olive-robotics/bots_bento_icra24/docs/images/6.JPG

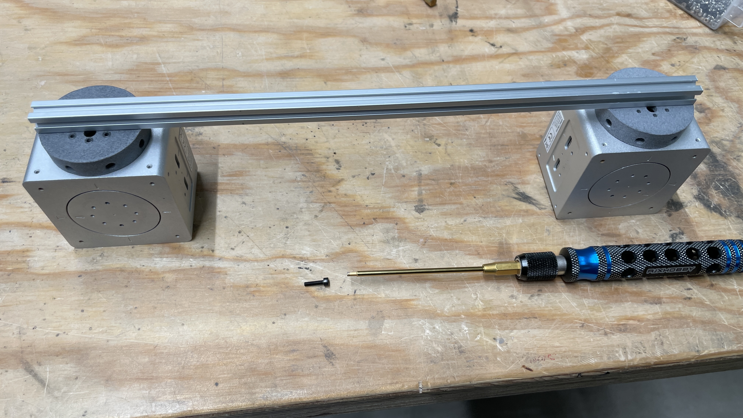
docs/images/6.JPG
