olive-robotics/bots_bento_icra24/docs/images/12.JPG

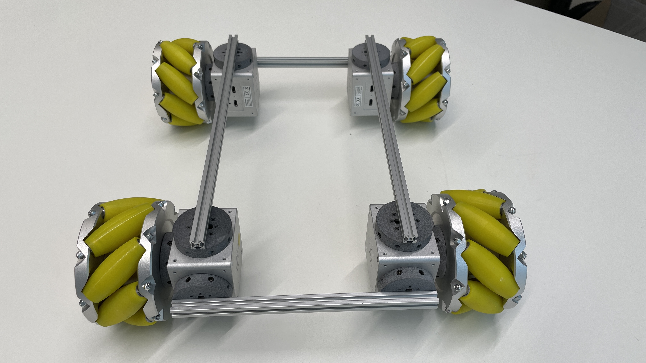
docs/images/12.JPG
