olive-robotics/bots_bento_icra24/docs/images/ant_wire2.png

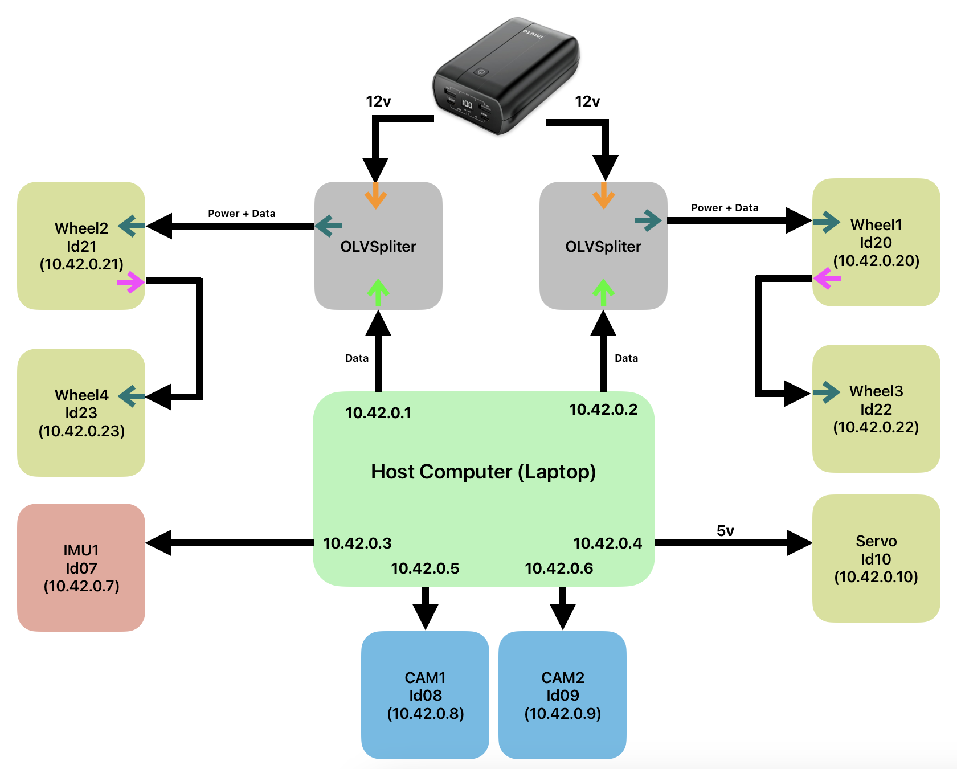
docs/images/ant_wire2.png
