olive-robotics/bots_bento_icra24/docs/images/ant_wire3.png

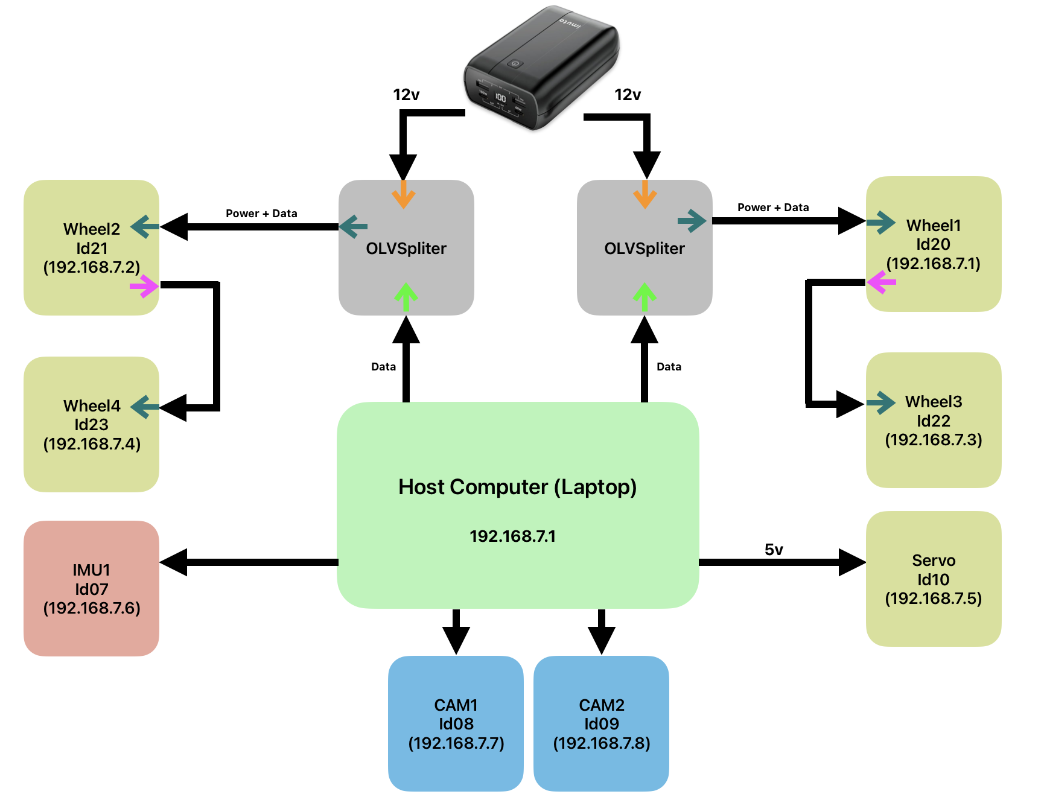
docs/images/ant_wire3.png
