olive-robotics/bots_bento_icra24/docs/images/splitter.JPG

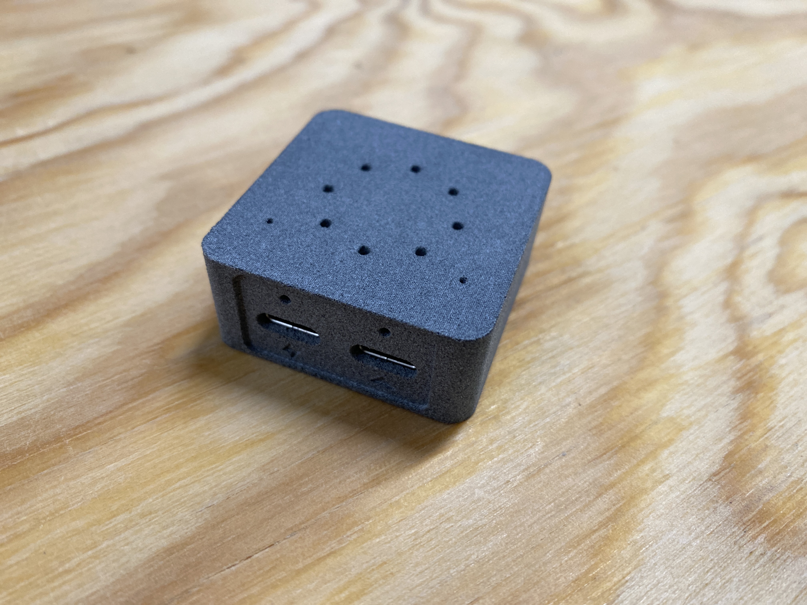
docs/images/splitter.JPG
