olive-robotics/bots_bento_icra24/images/1.png

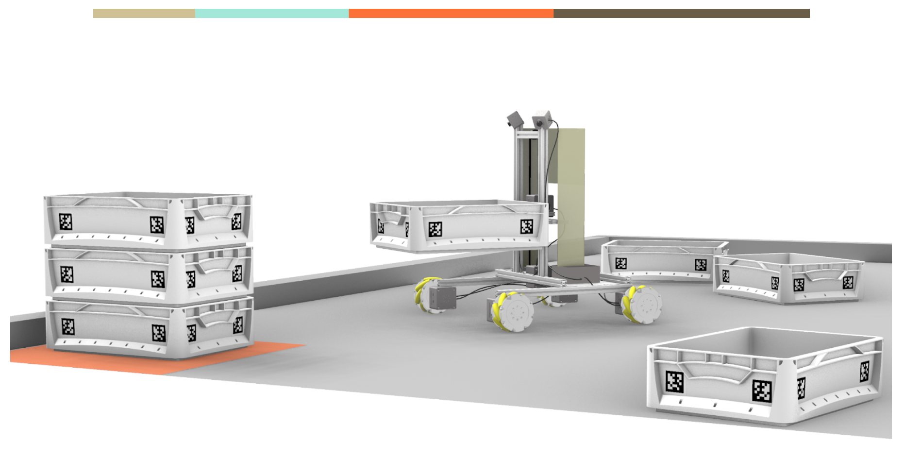
images/1.png
