olive-robotics/bots_bento_icra24/images/2xWheel_PlasticBox_400х300_v0.png

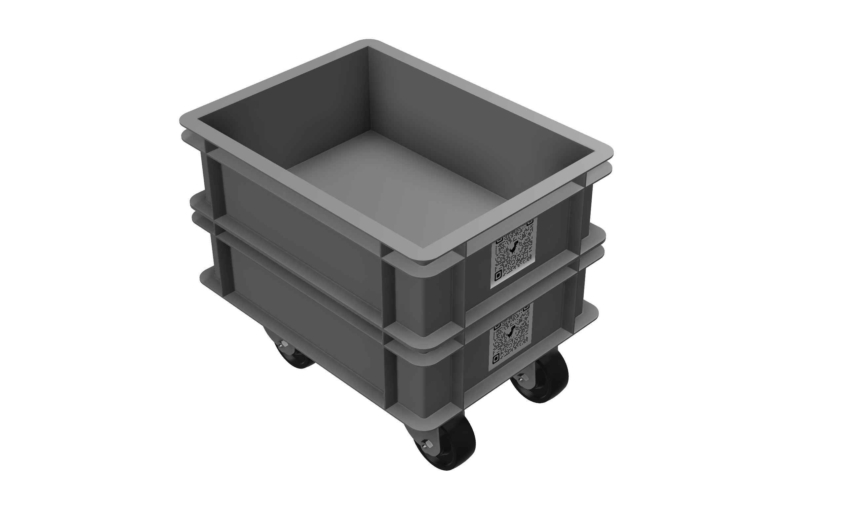
images/2xWheel_PlasticBox_400х300_v0.png
