olive-robotics/bots_bento_icra24/images/3.png

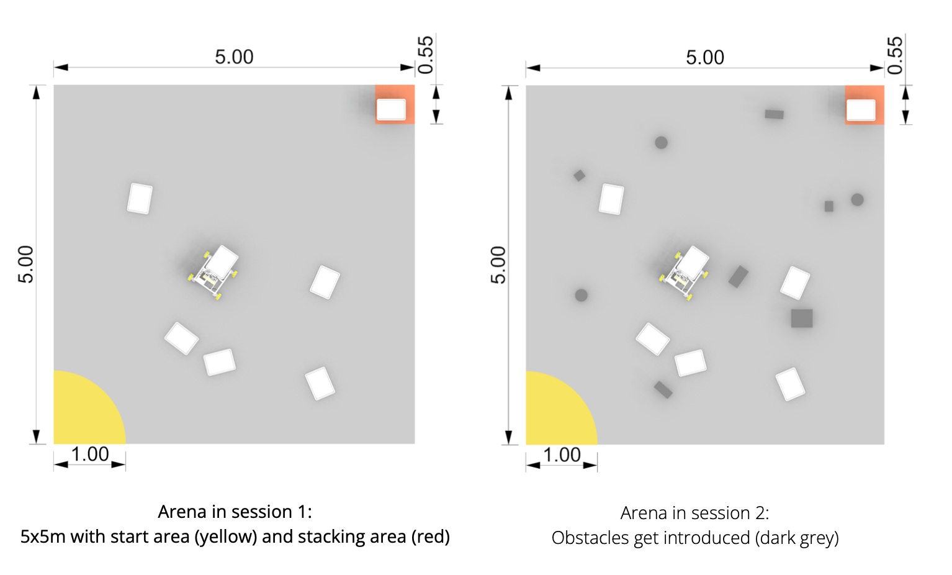
images/3.png
