olive-robotics/bots_bento_icra24/images/3xWheel_PlasticBox_400х300_v0.png

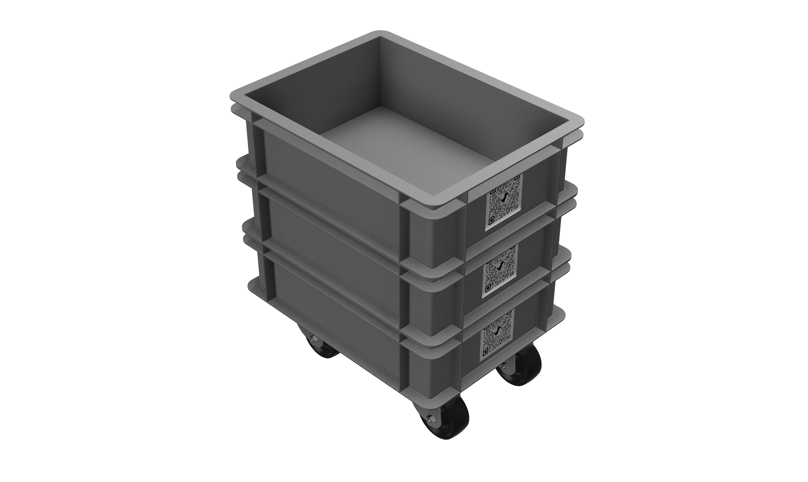
images/3xWheel_PlasticBox_400х300_v0.png
