olive-robotics/bots_bento_icra24/images/13.png

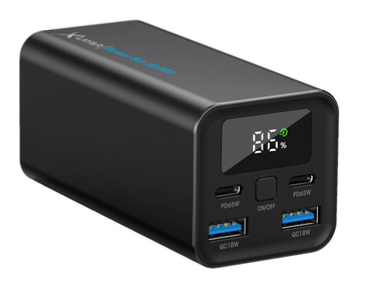
images/13.png
