olive-robotics/bots_bento_icra24/images/15.png

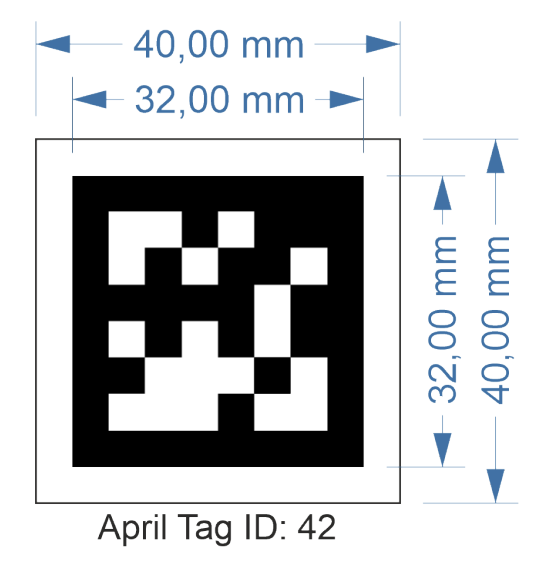
images/15.png
