olive-robotics/bots_bento_icra24/images/17.png

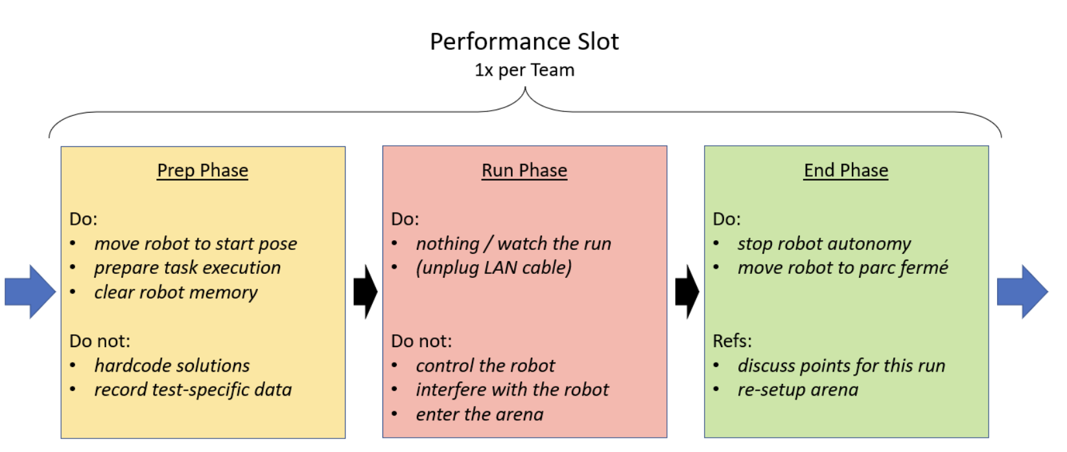
images/17.png
