olive-robotics/bots_bento_icra24/images/a1-3.png

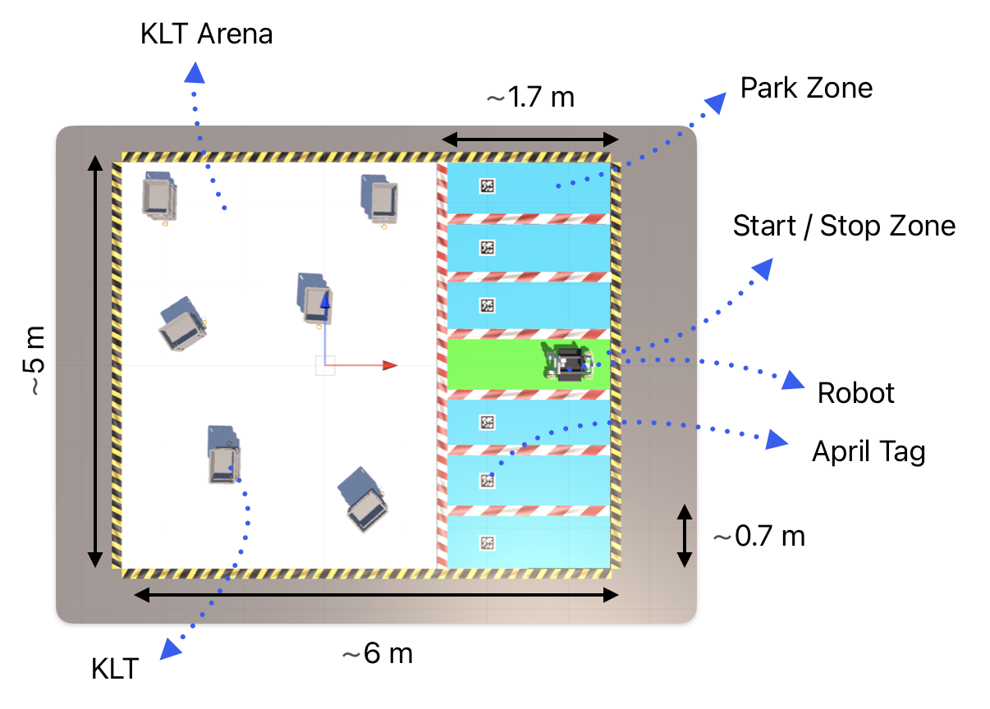
images/a1-3.png
