olive-robotics/bots_bento_icra24/images/a1.png

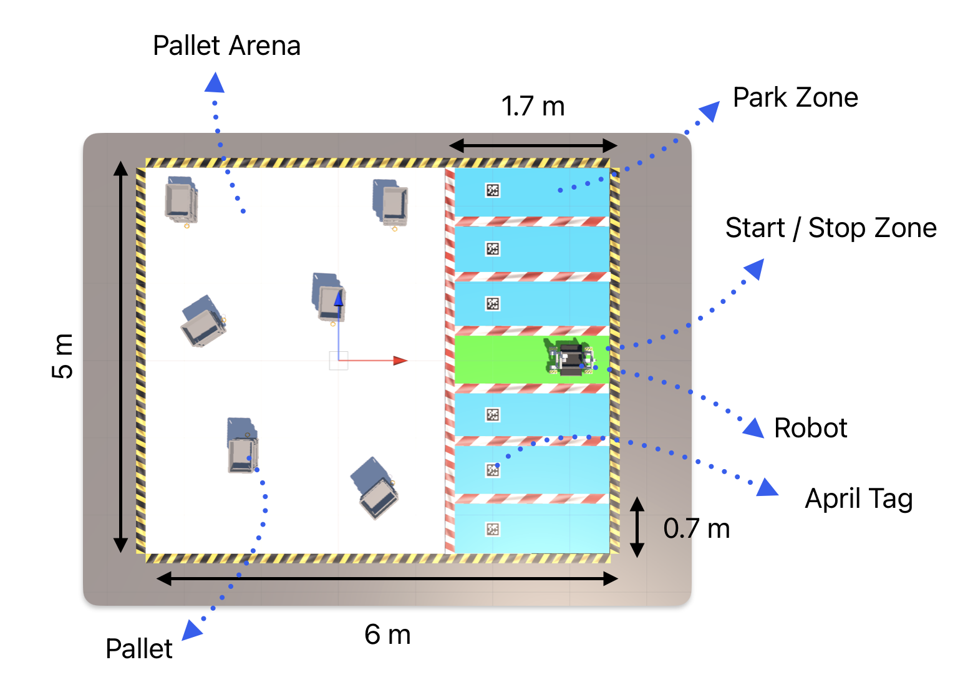
images/a1.png
