olive-robotics/bots_bento_icra24/images/a4-2.png

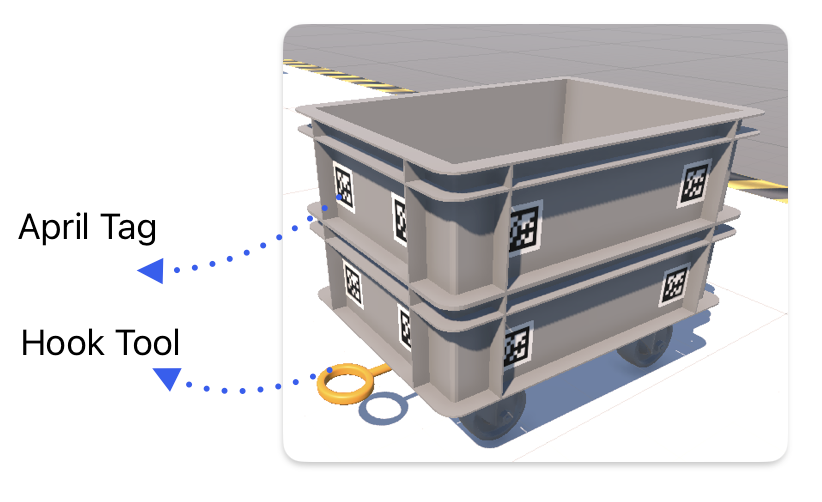
images/a4-2.png
