olive-robotics/bots_bento_icra24/images/a4.png

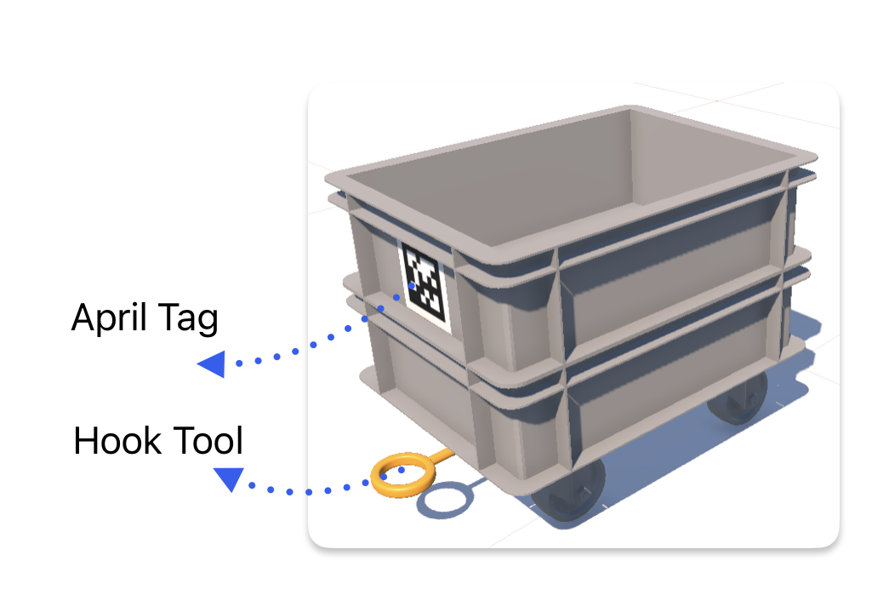
images/a4.png
