olive-robotics/bots_bento_icra24/images/ant.png

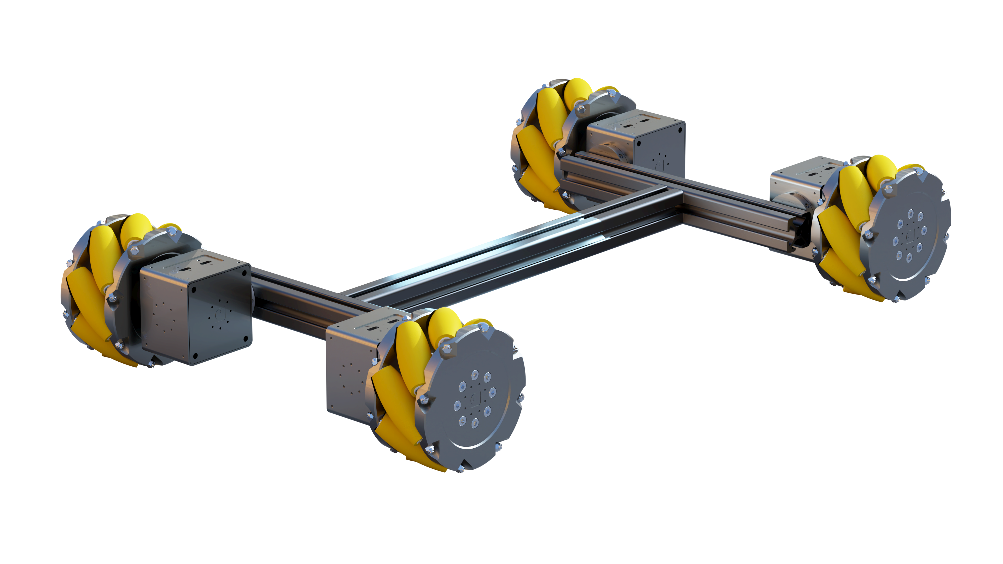
images/ant.png
