olive-robotics/bots_bento_icra24/images/bento.webp

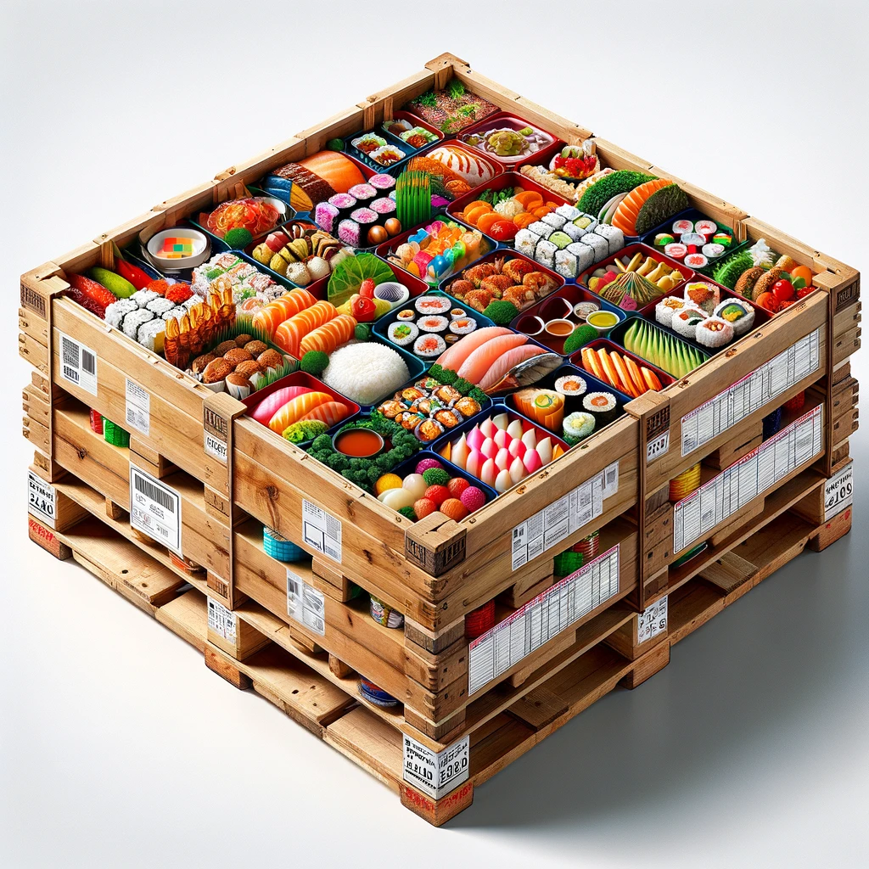
images/bento.webp
