olive-robotics/bots_bento_icra24/images/Competition_A1_v3.png

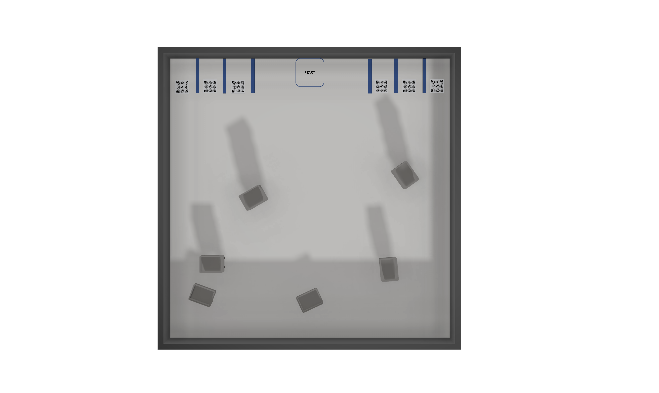
images/Competition_A1_v3.png
