olive-robotics/bots_bento_icra24/images/Competition_A1_v4.png

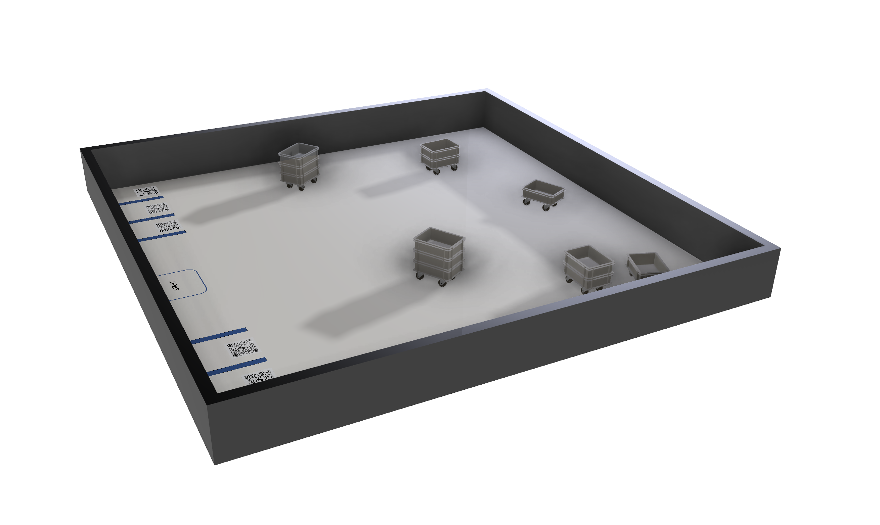
images/Competition_A1_v4.png
