olive-robotics/bots_bento_icra24/images/cover_2mb.gif

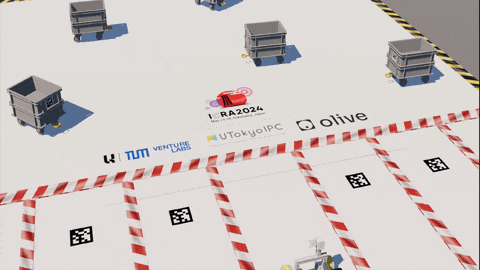
images/cover_2mb.gif
