olive-robotics/bots_bento_icra24/images/ems.png

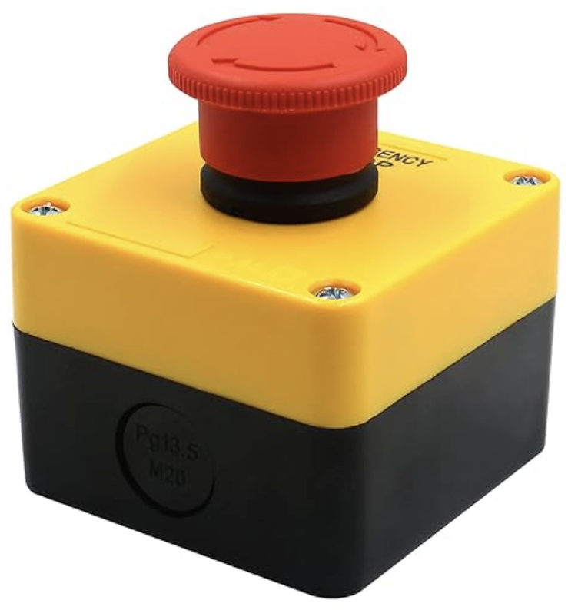
images/ems.png
