olive-robotics/bots_bento_icra24/images/grid.png

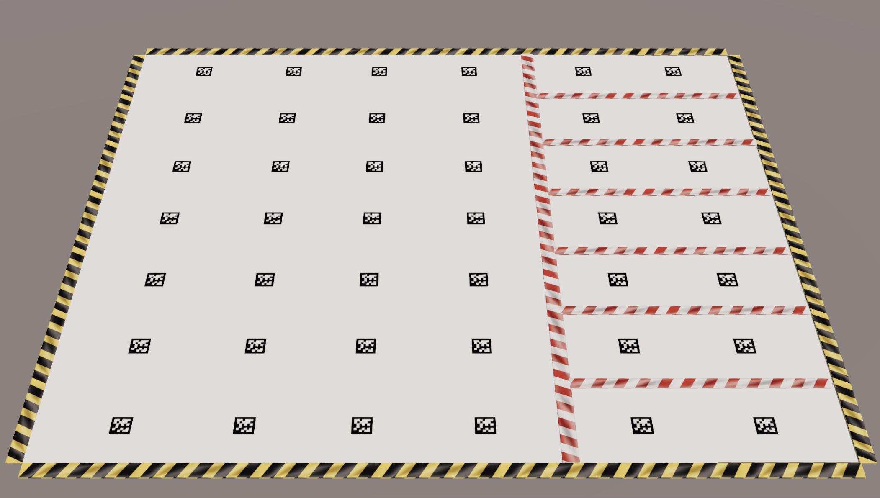
images/grid.png
