olive-robotics/bots_bento_icra24/images/klt/1.jpg

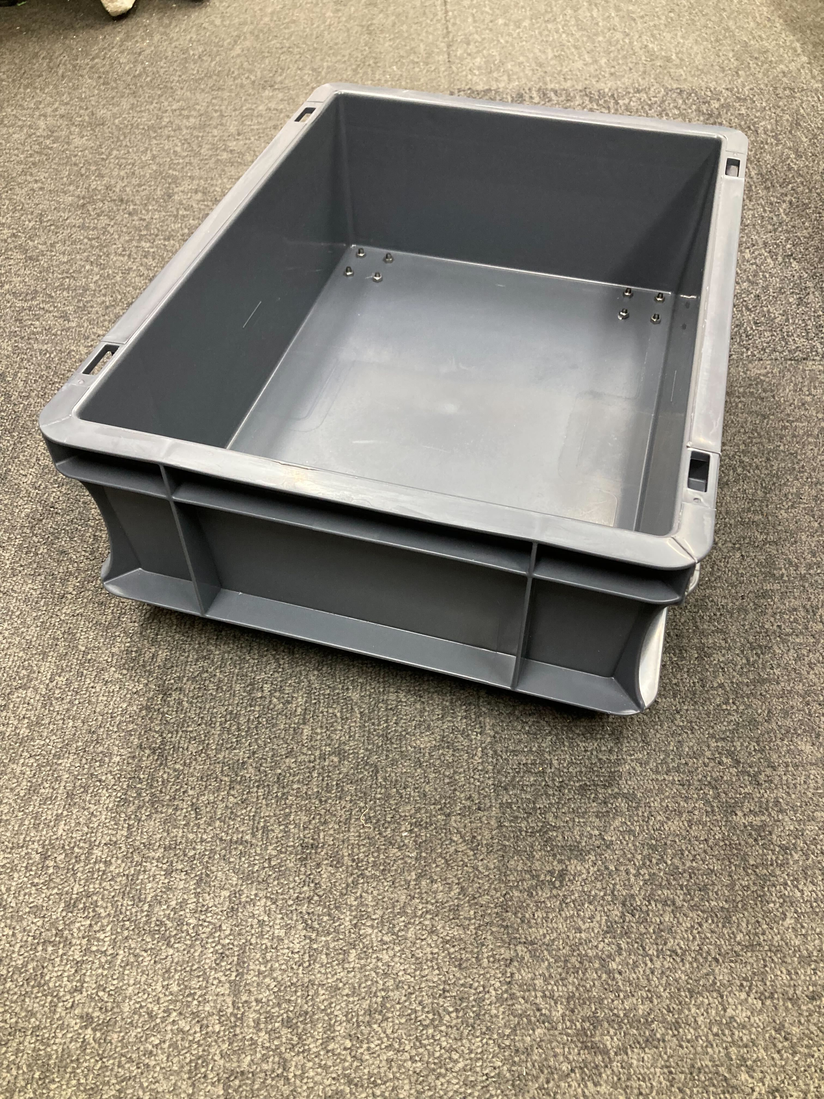
images/klt/1.jpg
