olive-robotics/bots_bento_icra24/images/klt_real.jpg

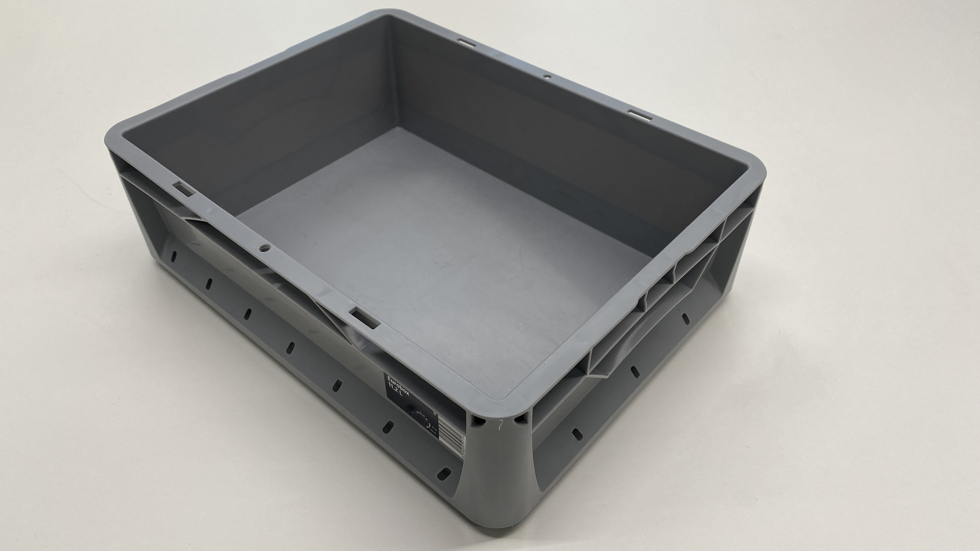
images/klt_real.jpg
