olive-robotics/bots_bento_icra24/images/klt_simple.png

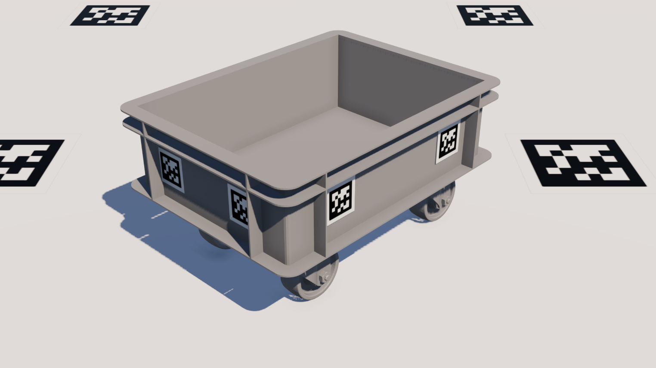
images/klt_simple.png
