olive-robotics/bots_bento_icra24/images/lens.png

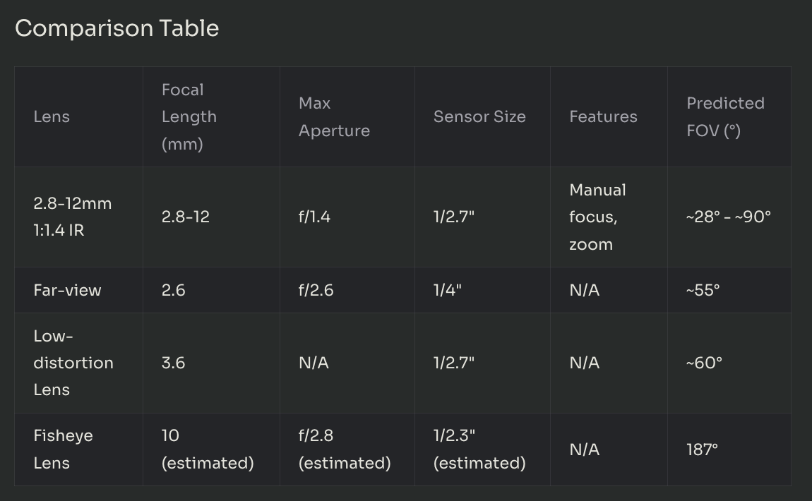
images/lens.png
