olive-robotics/bots_bento_icra24/images/Wheel_PlasticBox_400х300_v2.png

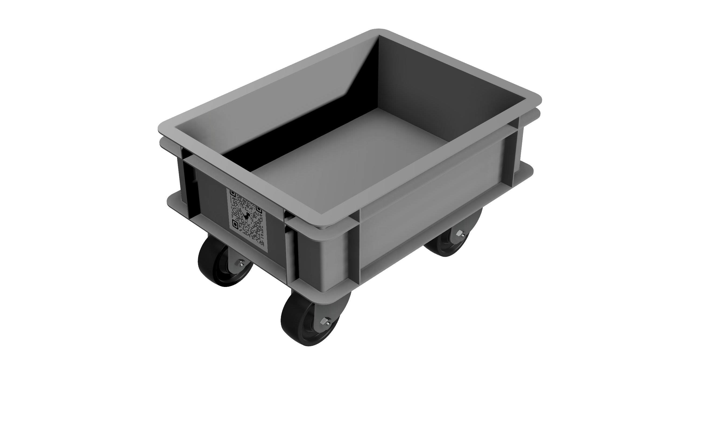
images/Wheel_PlasticBox_400х300_v2.png
