olive-robotics/bots_bento_icra24/3d_models/Camera/v3/cover_v1.step

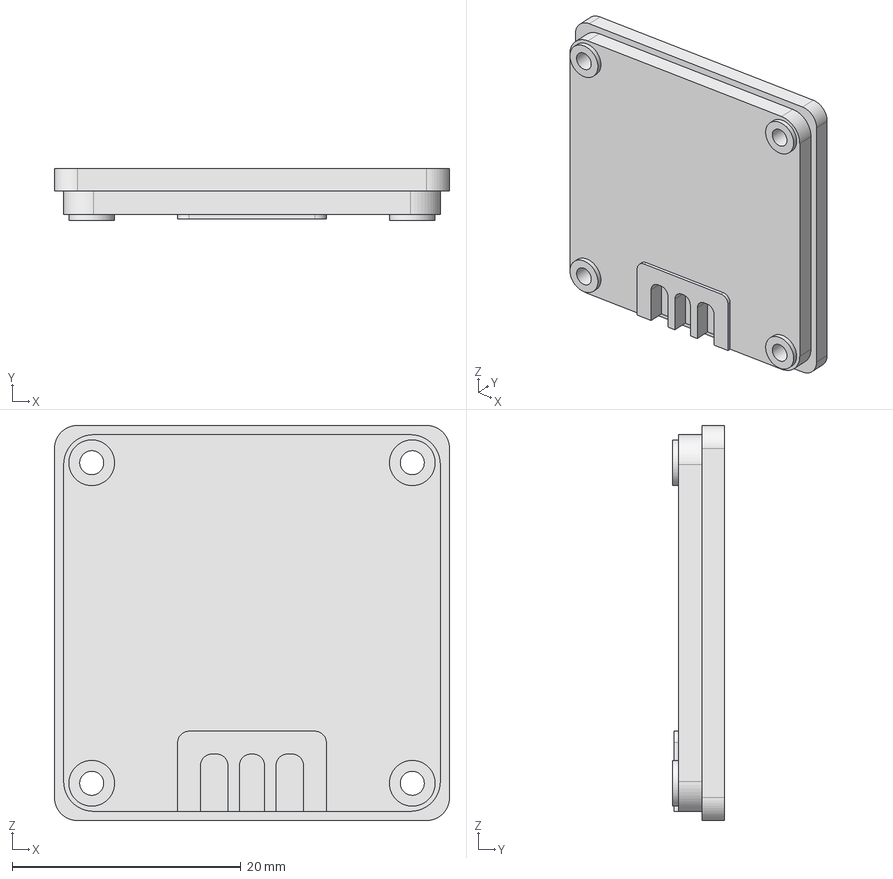
[picture p103: CAD file, 2024-02-18]
3d_models/Camera/v3/cover_v1.step
34.5 x 4.55 x 34.5 mm
