olive-robotics/bots_bento_icra24/3d_models/Imu/v3/imu_base_v3.step

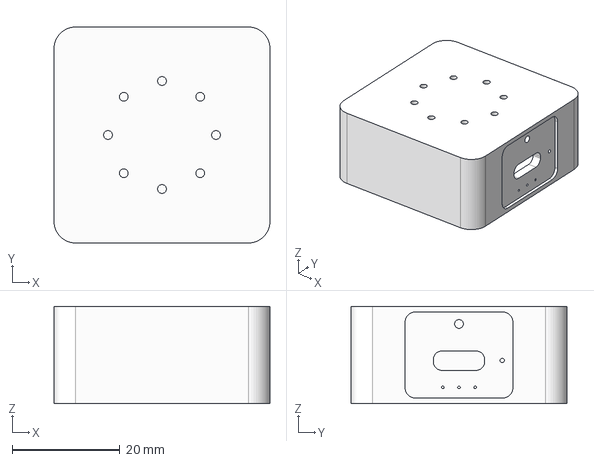
[picture p104: CAD file, 2024-02-18]
3d_models/Imu/v3/imu_base_v3.step
40.0 x 40.0 x 18.0 mm
