olive-robotics/bots_bento_icra24/3d_models/Pallet/2xWheel_PlasticBox_400х300_v5.step

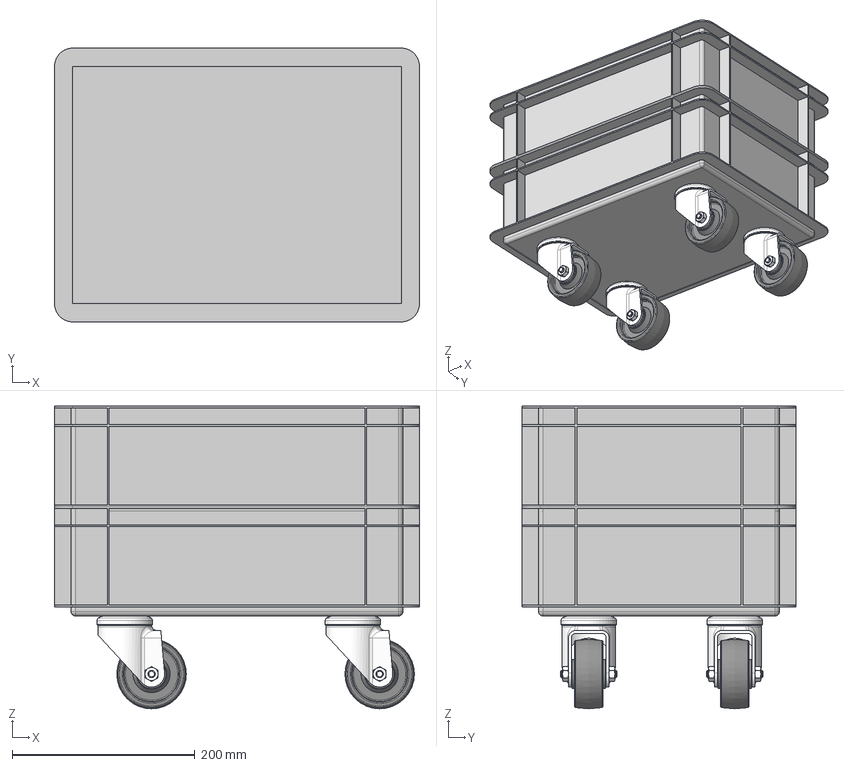
[picture p105: CAD file, 2024-02-19]
3d_models/Pallet/2xWheel_PlasticBox_400х300_v5.step
400.0 x 300.0 x 331.6 mm
9795T42_Swivel Caster x 4
PlasticBox_400х300
