olive-robotics/bots_bento_icra24/3d_models/Camera/v3/camera-base_v1.step

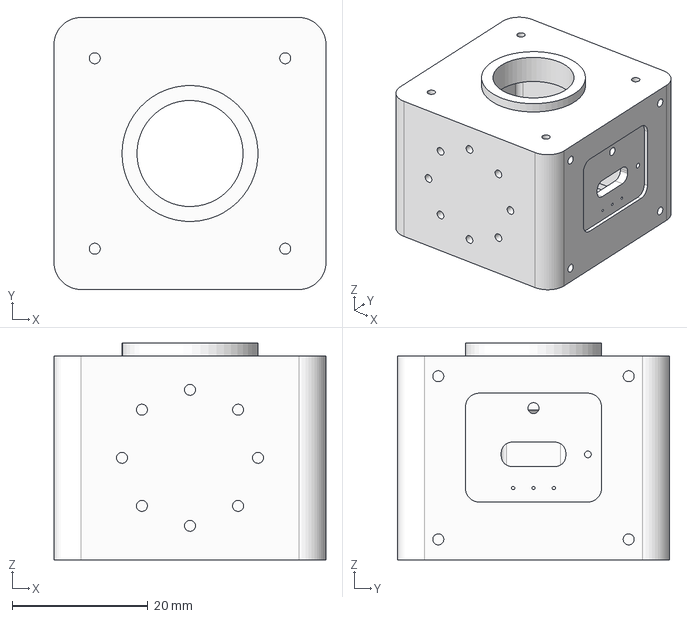
[picture p106: CAD file, 2024-02-18]
3d_models/Camera/v3/camera-base_v1.step
40.0 x 40.0 x 31.9 mm
