olive-robotics/bots_bento_icra24/3d_models/BoltX/Bolt-Hex-M-plastic v4.stl

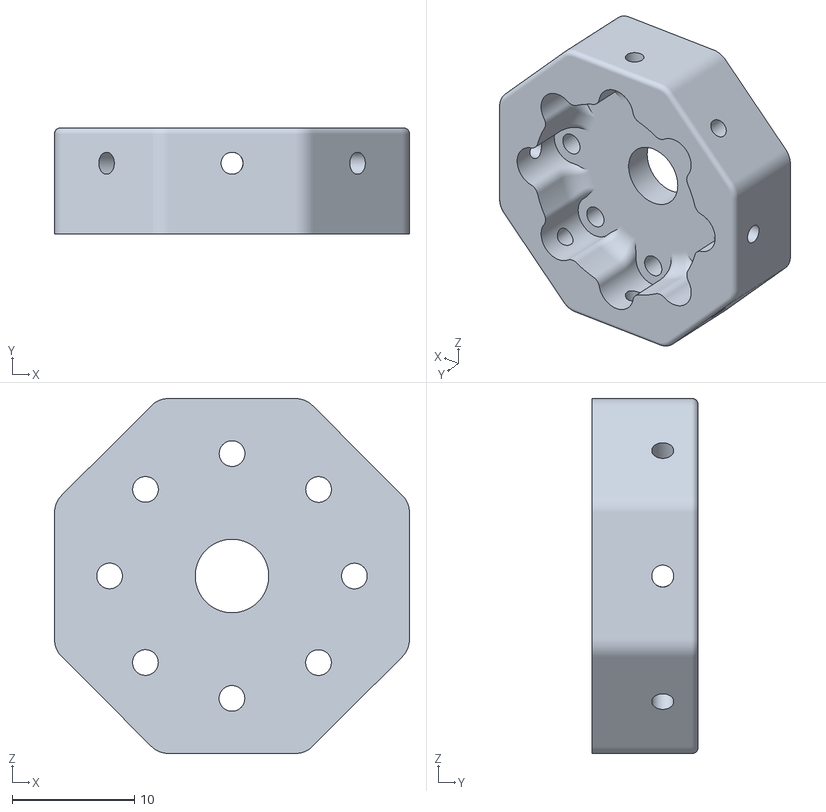
[picture p107: CAD file, 2024-02-18]
3d_models/BoltX/Bolt-Hex-M-plastic v4.stl
29.0 x 8.70 x 29.0
