olive-robotics/bots_bento_icra24/3d_models/BoltX/Bolt-Hex-F-plastic v4.stl

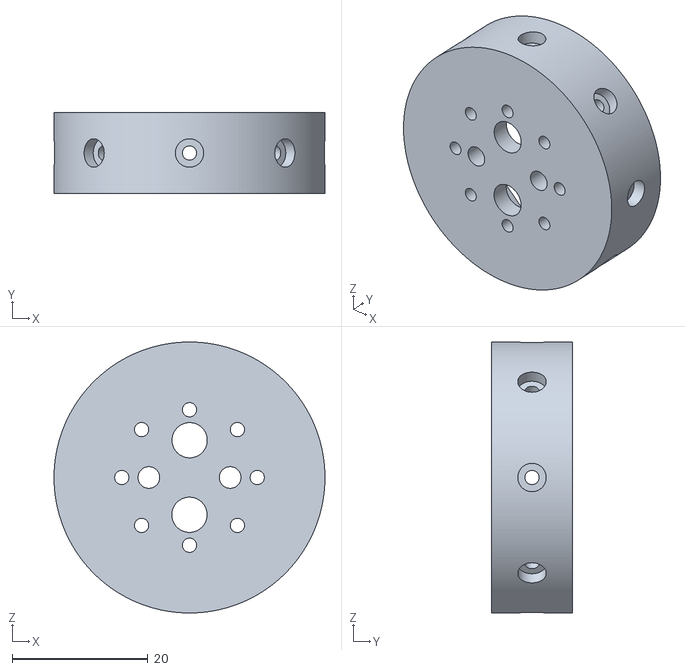
[picture p108: CAD file, 2024-02-18]
3d_models/BoltX/Bolt-Hex-F-plastic v4.stl
40.0 x 12.0 x 40.0
