olive-robotics/bots_bento_icra24/(list of files, cad)

Other CAD files:
3d_models/Camera/v3/Meshes/camera_asm_full v14.3dm
3d_models/Imu/v3/Meshes/IMU-ASM v7.3dm
