olive-robotics/bots_bento_icra24/docs/tutorial.md

# Robot Building Tutorial

## A) Mechanics 

🪜 **Step0:**

Prepare the boltx connector.

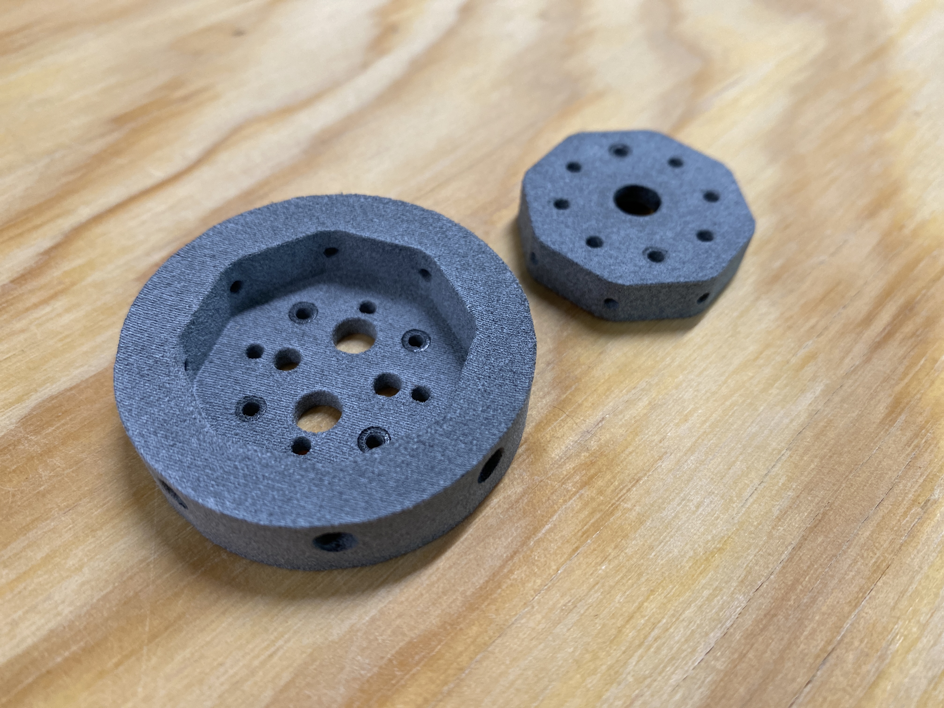
[picture p109: docs/images/boltx.JPG]
Step 0


🪜 **Step1:**
Take one motor and add the boltx to it.

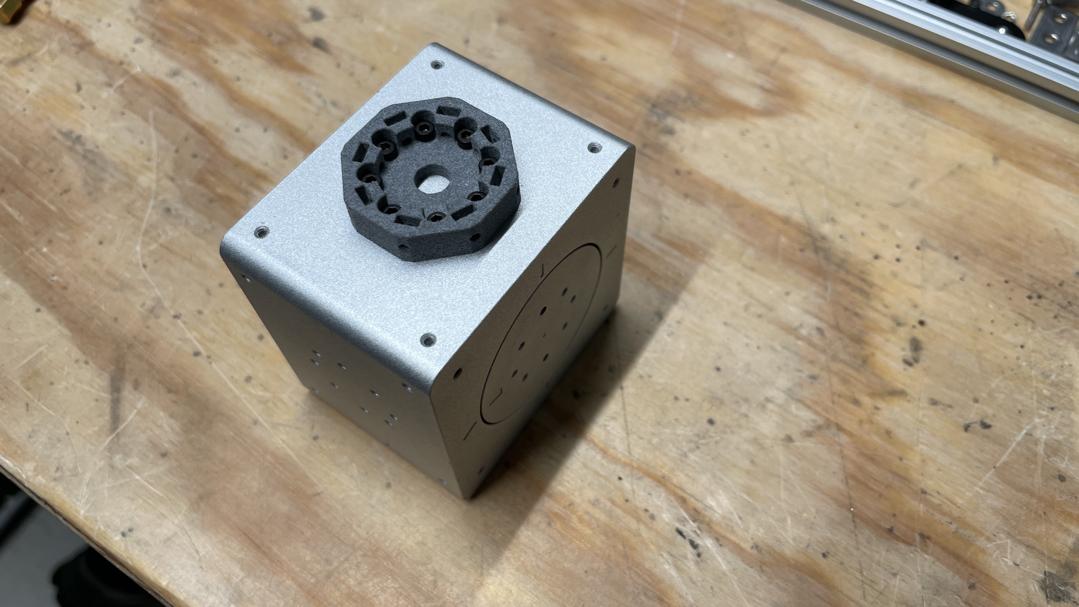
[picture p110: docs/images/1.JPG]
Step 1


🪜 **Step2:**
Repeat this step to have 2 motors
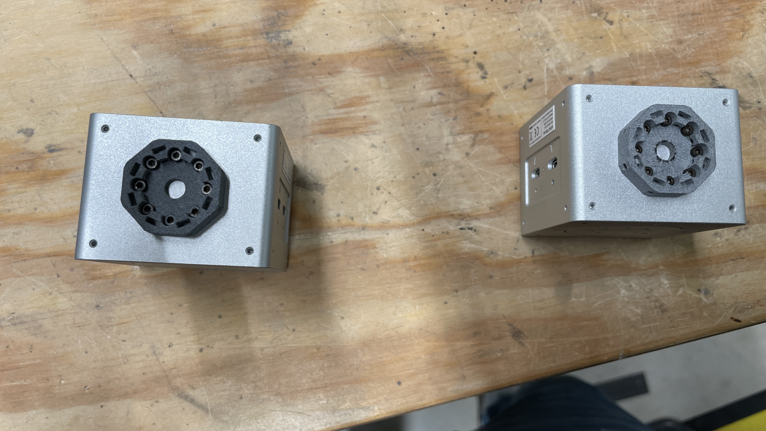
[picture p111: docs/images/2.JPG]
Step 2


🪜 **Step3:**
Take a 30 cm T-frame and add two boltx to each side of it.
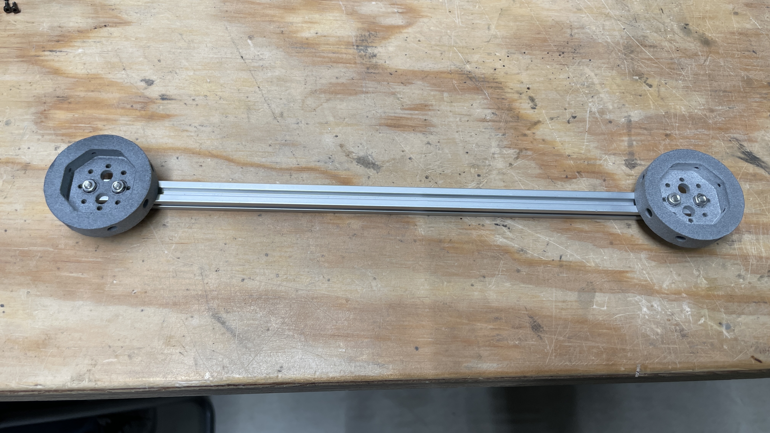
[picture p112: docs/images/3.JPG]
Step 3


🪜 **Step4:**
Make sure you lock the screws correctly.
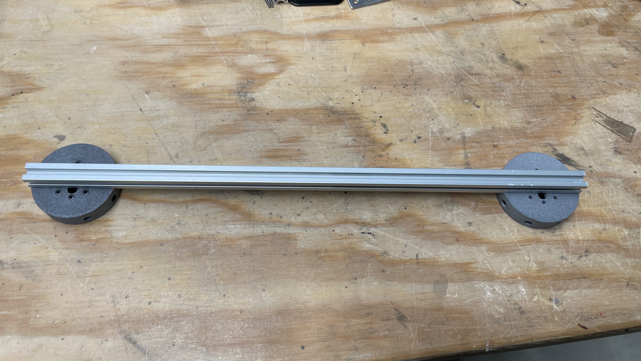
[picture p113: docs/images/4.JPG]
Step 4


🪜 **Step5:**
Then connect the T-frame structure to the motors.
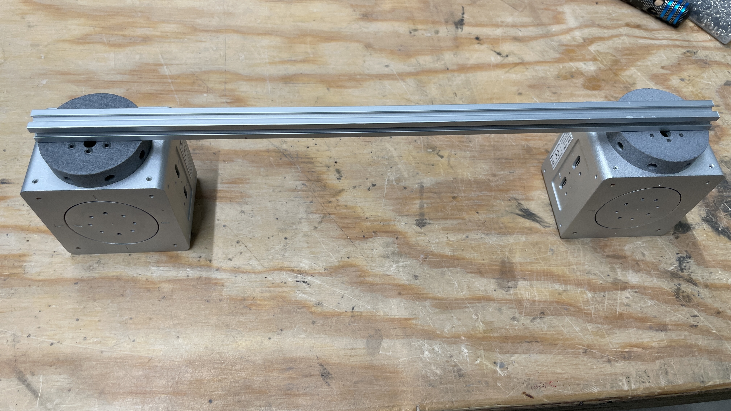
[picture p114: docs/images/5.JPG]
Step 5


🪜 **Step6:**
Then install another boltx to the wheel
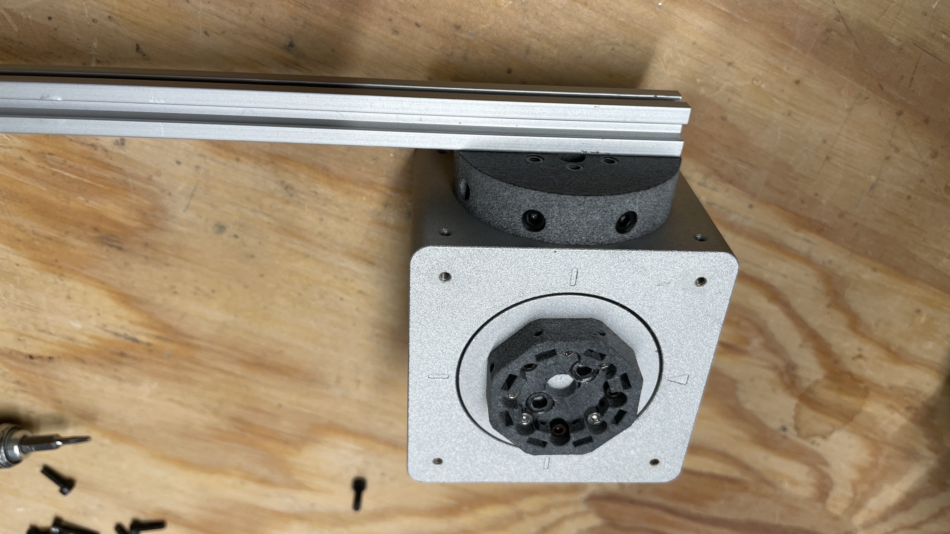
[picture p115: docs/images/7.JPG]
Step 6


🪜 **Step7:**
Then install the wheels. Check the step 10 to make sure you install the wheels in the currect direction.
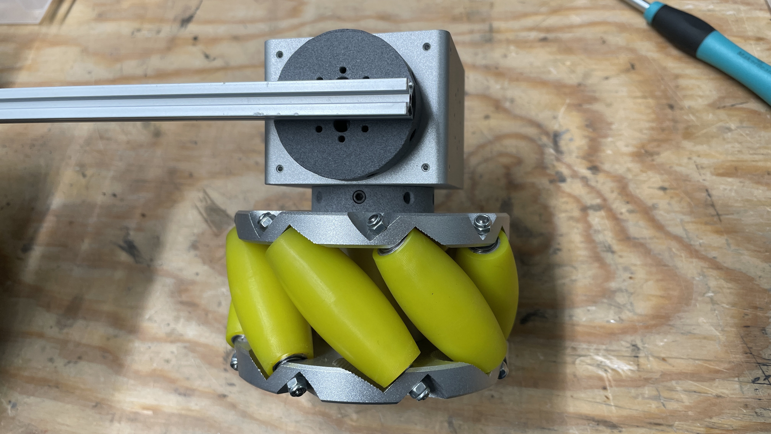
[picture p116: docs/images/8.JPG]
Step 7


🪜 **Step8:**
Build the complete frame for 4x motors.
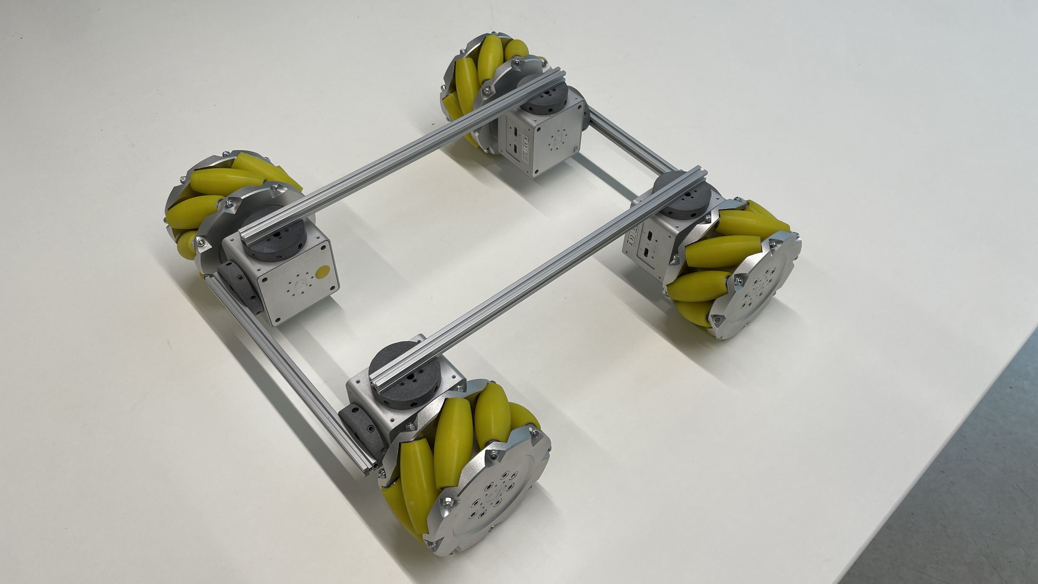
[picture p117: docs/images/9.JPG]
Step 8


🪜 **Step9:**
Install two other T-frame structures similar to previus step to have a cube shape base.
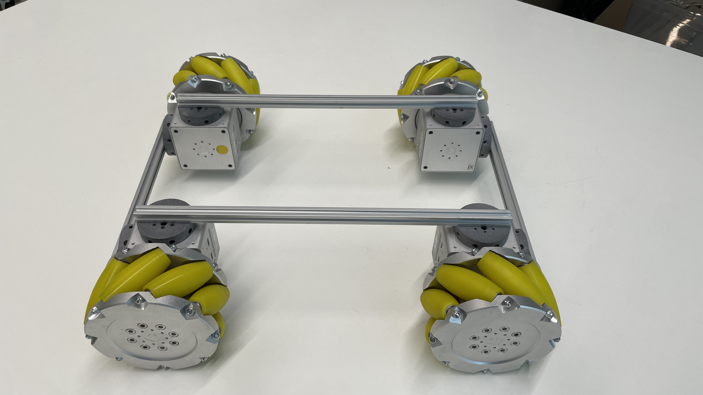
[picture p118: docs/images/10.JPG]
Step 9


🪜 **Step10:**
Make sure you install the wheels correctly.
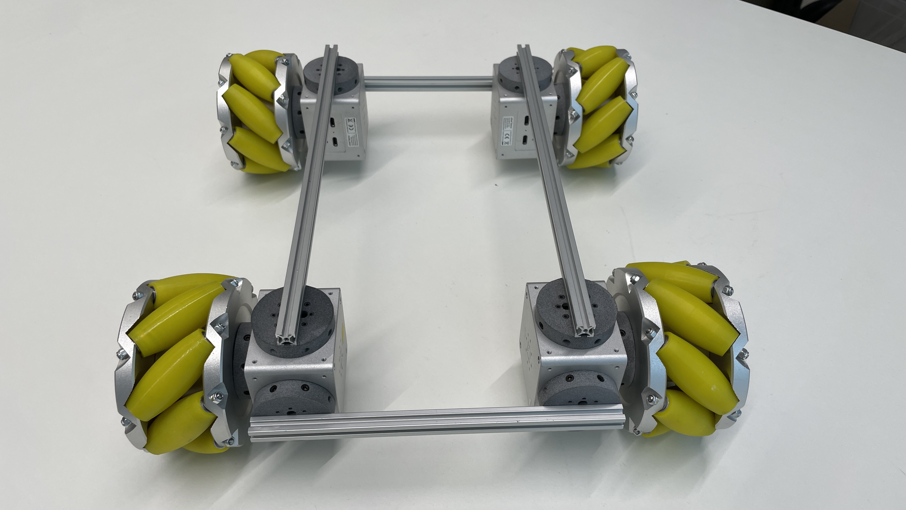
[picture p119: docs/images/11.JPG]
Step 10


## B) Electronics and Components

🪜 **Step11:**
Make sure you follow the wire connection as shown here:
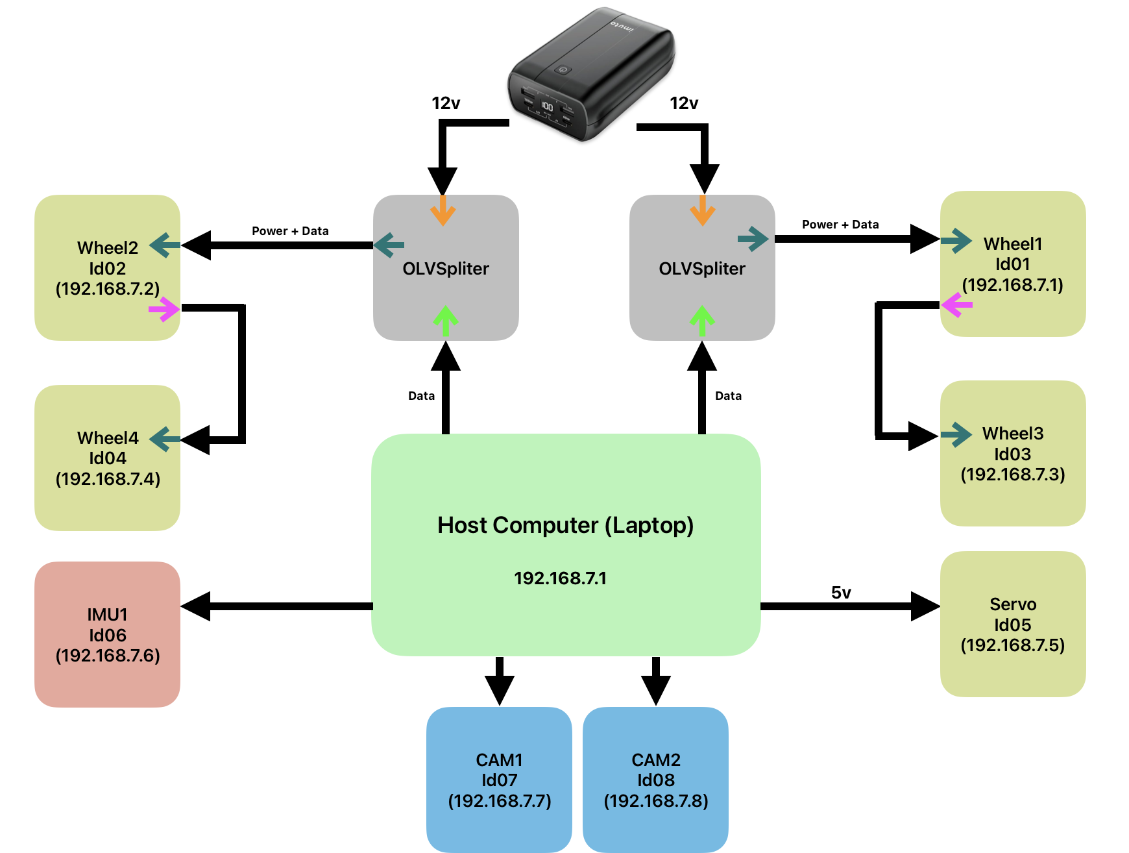
[picture p120: docs/images/ant_wire4.png]


🪜 **Step12:**
You should be able to move the robot as the video below:
Step 11

🪜 **Step13:**
Make sure you have connected the splitter correctly for base motors. Follow the steps, first connect the servo side, then data and at the end the power. 

splitter version 1.0
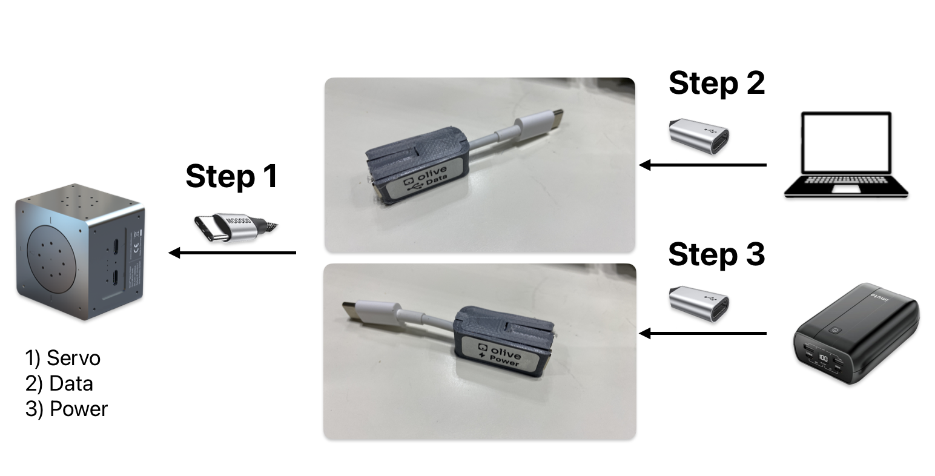
[picture p121: docs/images/splitter2.png]


splitter version 2.0
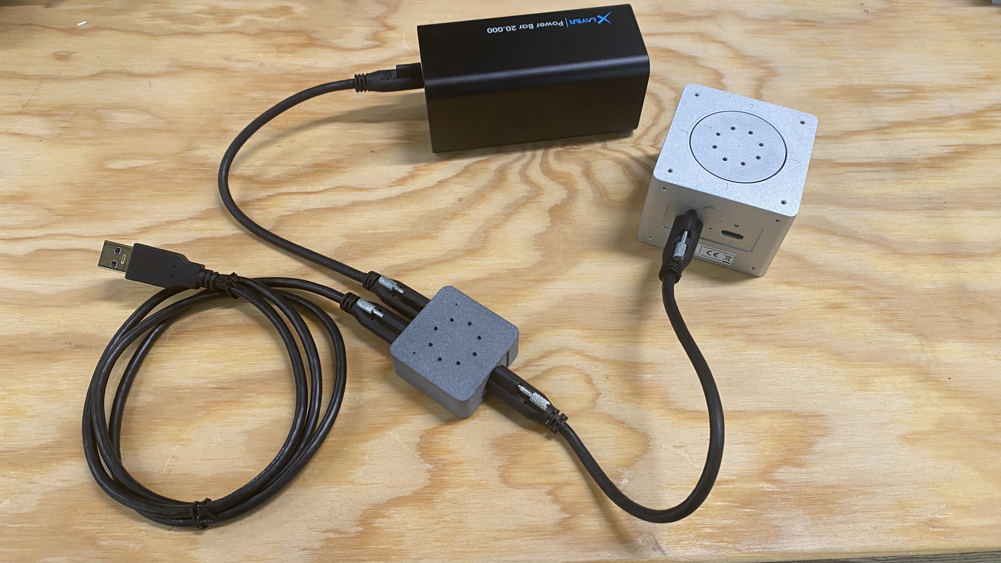
[picture p122: docs/images/motor_12v_example.JPG]


Step 11

🪜 **Step14:**
Example IMU and Camera components. You are free to install them in a way you like on the robot:

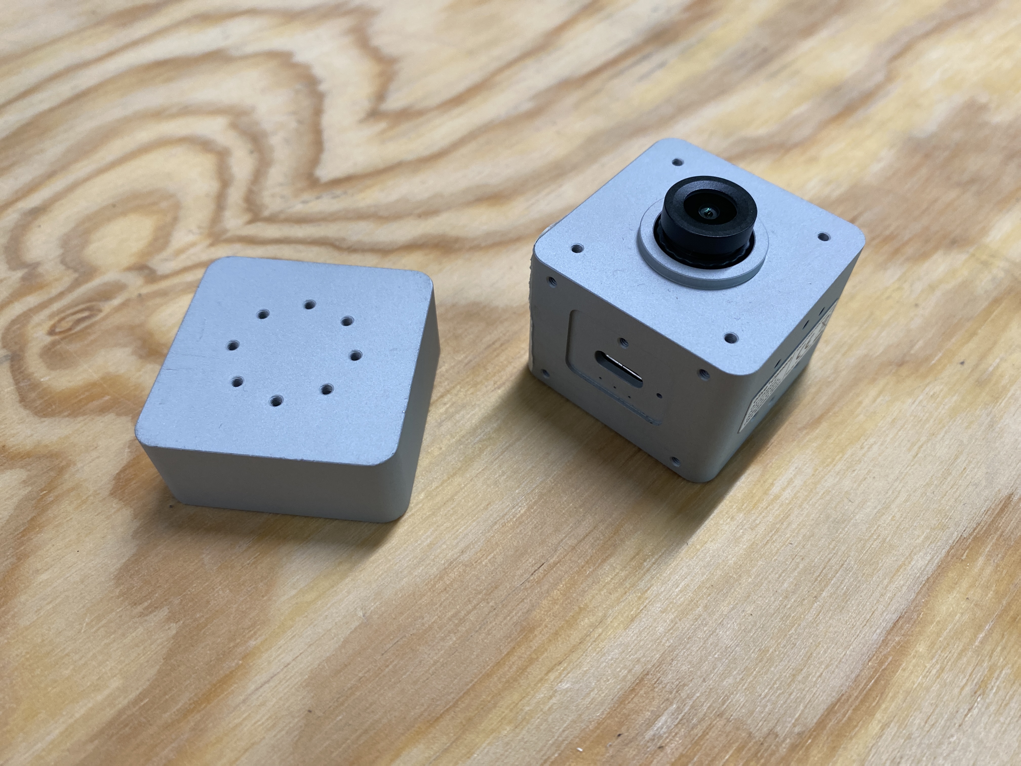
[picture p123: docs/images/imu_camera.JPG]


🪜 **Step15:**
Now you can build a innovative hook for KLT sorting. You will need the 5th servo motor to actuate the hook system in position mode. Here is an example:

You can use the passive parts to extend the robot:



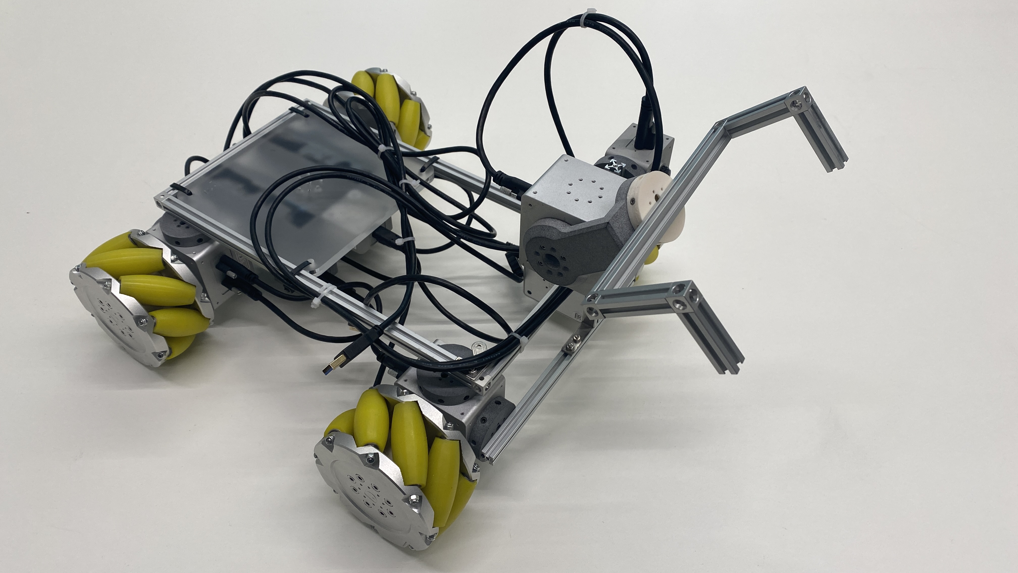
[picture p125: docs/images/robot_example.JPG]


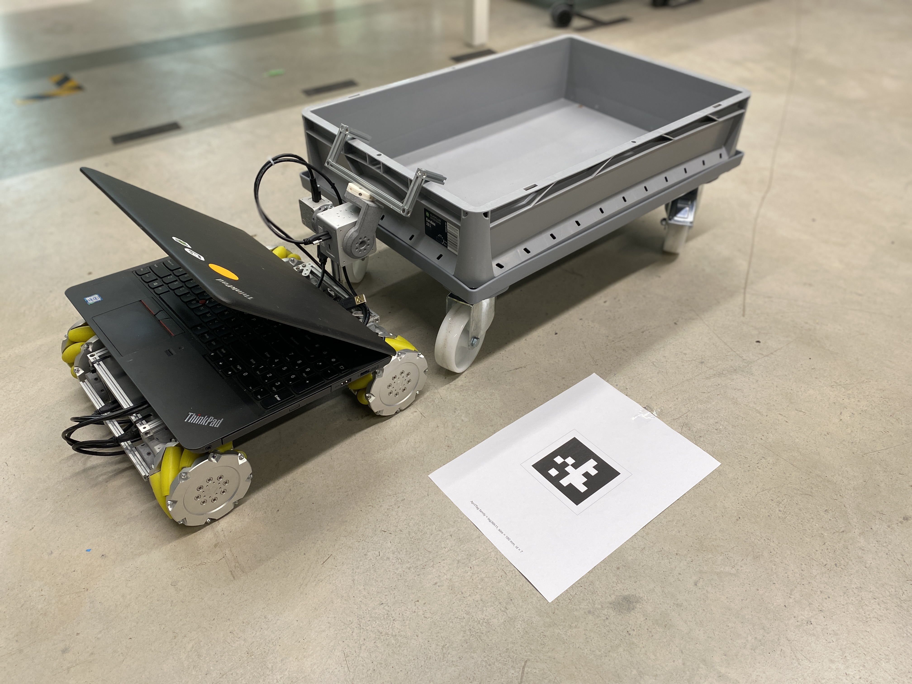
[picture p126: docs/images/robot_klt_example.JPG]


Step 11

## C) Software

#### C.1) Network Bridge Setup

We recomend to use a bridge to enable a universal network interface between all olive components. To do that please follow the Networking documentation available here:

https://docs.olive-robotics.com/software/olixos/network.html#solution-2-network-bridge

#### C.2) ROS2 Python examples

To control the robot base you can follow the example provided here:

https://github.com/olive-robotics/bots_bento_icra24/blob/main/src/base/base_control.py
