olive-robotics/bots_bento_icra24/(threads)

Thread 1 (2024-04-27):

Questions on the competition

marlvernchimbwanda, 2024-04-27:
1. Do we get a map? Can we map?
2. Can we knock other KLTs as we go?
3. Can we cover the april tags as our technical challenge?
4. Will we be given the locations of the april tags on the KLTs? Or will they at least be symmetrically placed?
5. Do the floor tags have unique IDs from one another

@cxdcxd @arn3r05t

cxdcxd, 2024-04-28:
Do we get a map? Can we map?

You will not get any map. Yes you can map the environment during the test run. But the KLT's will be placed randomly and you dont know the place of them.

Can we knock other KLTs as we go?

Yes, up to the point that you don't damage the robot.

Can we cover the april tags as our technical challenge?

Yes.

Will we be given the locations of the april tags on the KLTs? Or will they at least be symmetrically placed?

It will be symmetrically placed and it will be standard on all of them.

Do the floor tags have unique IDs from one another

Yes, we will put different id numbers and also give you the numbers in advance so you can use it for robot odometry and localization.

leon-seidel, 2024-04-28:
Is it still planned that the Apriltag code on the KLTs will be the same as the tag codes of their goal box on the ground? If the tags on the KLTs will be smaller than the tags on the ground this would probably require changes in standard Apriltag libraries, as tag localisation only works for each tag code having a consistent size.

cxdcxd, 2024-04-28:
We have two sizes of tags: 10cm and 20cm. It's clear that we'll use the smaller 10cm tags for KLT and the larger ones for ground.

leon-seidel, 2024-04-28:
Thanks! Will the same tag code, for example 36h11_42, be used for both on the ground and on a KLT?

cxdcxd, 2024-04-28:
Yes.

cxdcxd, 2024-04-28:
https://github.com/rgov/apriltag-pdfs/tree/main/tag36h11/a4

Closed 2024-05-27.

Thread 2 (2024-04-29):

Fisheye FOV | Motor torque mode | Hook design

Rudresh172, 2024-04-29:
1. Will there be an option to use the fisheye lens on the camera (1.8 mm)? If yes, what is the FOV of the fisheye lens camera setup? How reliable are the rectified images according to your previous testing?

2. What function does the ROS service '/setTorqueEnable' provide? Does it enable us to view the torque applied by the motor at that instant or does it give command to the motor to apply the specified torque?

3. If we design a custom hook for the KLT, can we fit those 3d printed hooks to all the 6 KLTs during our run?

cxdcxd, 2024-04-29:
1) Will there be an option to use the fisheye lens on the camera (1.8 mm)? If yes, what is the FOV of the fisheye lens camera setup? How reliable are the rectified images according to your previous testing?

Yes, you can use the fisheye. I will update the different lens specifications in the Rulebook asap.

2) What function does the ROS service '/setTorqueEnable' provide? Does it enable us to view the torque applied by the motor at that instant or does it give command to the motor to apply the specified torque?

It is only useful for position mode servo motor. It is only an enabler of the torque to the motor. You have to call it first then you can send goal position via the topic. Its like a emergency switch to cut the power.

3) If we design a custom hook for the KLT, can we fit those 3d printed hooks to all the 6 KLTs during our run?

The idea of the competition is to not touch the KLTs and you can't customize them by installing aditional parts. You can use this idea for the open challenge part only.

Rudresh172, 2024-04-29:
Thanks for the clarification! We have some additional questions -

4. There seems to be conflicting information regarding the AR tag on KLTs.
Section 3.2.8 states -
```
To facilitate identification and sorting, each KLT is equipped with an April Tag on both its front and back sides. These tags contain unique IDs, enabling the robot to accurately recognize and handle the KLTs according to the competition's requirements.
```

Section 3.2.8.1 states -
```
2x April Tags will be installed on each side and on each KLT. In this example for two KLT it will be 16 Tags. The id for all Tags will be same and you can identify the side or front from distance between each April Tag.
```

5. Will this L-shaped mount be also provided to us or do we need to arrange for it ourselves?
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

cxdcxd, 2024-04-29:
4) It is now more clear and is corrected. Thanks.
5) Yes, i have updated the component list too.

Rudresh172, 2024-05-04:
Hey @cxdcxd,

6. The Maker kit contains 6mm square headed MakerBeam bolts. Do we have more options for bolts for a custom camera mount? More length options would be highly appreciated since 3d printed parts might need some thickness to have enough strength.

cxdcxd, 2024-05-04:
You can bring any type of passive parts or screws and change things in a way you like. We will only give you the list we explained and the example base robot. Rest you can change in a way you like.

flerovious, 2024-05-08:
Are we provided with the supported lens mentioned here?
https://github.com/olive-robotics/bots_bento_icra24/blob/main/docs/rulebook.md#supported-camera-lenses

cxdcxd, 2024-05-08:
Yes, we will provide additional lenses so you can switch them out depending on the needs of your application.

Closed 2024-05-27.

Thread 3 (2024-04-30):

Number of Servos

maychristopher, 2024-04-30:
How many servos can / must we use?

The component list states five, the overview image shows six.
The latter is also stated by "To enhance its capabilities, you are tasked with creatively installing an additional 2 cameras and 2 actuators."

cxdcxd, 2024-04-30:
For sure 5 is fixed. But one is more like a backup. Depends on the situation and paricipents it can change to 6. But 5 is the official number of servos.

maychristopher, 2024-04-30:
Ok, thank you,

Closed 2024-04-30.

Thread 4 (2024-04-30):

Encoder Ticks | Odometry | Goal AR Tags

Spartan-Velanjeri, 2024-04-30:
Greetings,

1. From the base_control.py, I realised that we are directly giving velocity values to the wheels in order to move them around. Apart from Position or Velocity, is there any way to control the wheels? i.e. through Encoder Ticks and so on.
2. Do you have any code suggestion or boilerplate for the wheel odometry code ?
3. Can we already fix the positions of each AR Tag at the goal pose for the pallets in the map, since it is anyways going to be fixed?

Thank you !
Parthan

cxdcxd, 2024-04-30:
From the base_control.py, I realised that we are directly giving velocity values to the wheels in order to move them around. Apart from Position or Velocity, is there any way to control the wheels? i.e. through Encoder Ticks and so on.

you publish the goal velocity or position and the motor will control the rest. But yes you have the feedback from the wheels like the current velocity, position and the effort of the servo. It will be the standard joint_status message.

https://docs.ros.org/en/melodic/api/sensor_msgs/html/msg/JointState.html

Do you have any code suggestion or boilerplate for the wheel odometry code ?

No we dont have anything for odometery or slam or localization related examples. This is part of the competition.

Can we already fix the positions of each AR Tag at the goal pose for the pallets in the map, since it is anyways going to be fixed?

Yes the position for the goal position of the pallets are fixed and its a zone not a point even. You should park the pallet in the zone and it the goal zones are fixed.

cxdcxd, 2024-05-02:
In the latest update which we are working on we will publish joint state only. In the joint state you will get a sensor_msgs::msg::JointState message with position, velocity and effort. But yes the position will be between 0 and 2Pi radian. It will get zero every time it pass the zero position. You can use the velocity of the motor to have a continues position estimate by knowing the wheel size.

cxdcxd, 2024-05-02:
Update: For this update we will publish the continues and non continues encoders too. This is confirmed.

Spartan-Velanjeri, 2024-05-02:
If I understand this right, continuous encoders are when the servo  can rotate continuously in both directions, rather than being limited to a specific range of motion and non continuous encoders are like for a defined range ?

cxdcxd, 2024-05-02:
yes, now in the wheel mode motion control the position output is continues radian rotation and not limited to any range.

Spartan-Velanjeri, 2024-05-02:
> In the latest update which we are working on we will publish joint state only. In the joint state you will get a sensor_msgs::msg::JointState message with position, velocity and effort. But yes the position will be between 0 and 2Pi radian. It will get zero every time it pass the zero position. You can use the velocity of the motor to have a continues position estimate by knowing the wheel size.

Again just to clarify, when you say continuous radian rotation, it'll still go back zero position every time it does one full rotation?

cxdcxd, 2024-05-02:
no, in wheel mode it will go to infinity (+ or -). And you can make it zero by calling the setZero service. It will work like a continues encoder.

cxdcxd, 2024-05-02:
in position control mode (which you may use for hook) it will be limited in -Pi to Pi.

Spartan-Velanjeri, 2024-05-02:
Got it ! Thank you for your super quick response!

Have a great weekend ahead !
Parthan

Closed 2024-05-02.

Thread 5 (2024-05-04):

ROS Humble and Motors

Kevinpaulose05, 2024-05-04:
1. Do we necessarily need ROS Humble (Ubuntu 22.04) to run the components provided or will ROS Foxy (Ubuntu 20.04) work? We are currently using Ubuntu 20.04 ROS Foxy. Should we switch?

2. It is mentioned that we will be given four motors for the wheel, and one motor for the hook (five in total). Is there a sixth motor provided for the camera? It is mentioned that 2 actuators and 2 cameras are provided. Please provide some clarity about these motors and actuators.

cxdcxd, 2024-05-04:
Do we necessarily need ROS Humble (Ubuntu 22.04) to run the components provided or will ROS Foxy (Ubuntu 20.04) work? We are currently using Ubuntu 20.04 ROS Foxy. Should we switch?

It will work but to maximize compatibility and ensure we will not have unpredicted behaviors it is better to upgrade everything to Ubuntu 20.04 and ROS Humble.

It is mentioned that we will be given four motors for the wheel, and one motor for the hook (five in total). Is there a sixth motor provided for the camera? It is mentioned that 2 actuators and 2 cameras are provided. Please provide some clarity about these motors and actuators.

The official amount of the motors are 5 , which 4 you will use for the base and 1 for the hook. But yes you will have 1 more motor but that is backup. We should decide later that if you can use that also for the robot. Now consider you have 5 motors.

Kevinpaulose05, 2024-05-04:
Understood. Thanks!

Closed 2024-05-04.

Thread 9 (2024-05-09):

Use of hardware for technical challenge

flerovious, 2024-05-09:
I'd like to confirm the hardware limitations for the technical challenge portion of the competition. According to the rules listed [here](https://github.com/olive-robotics/bots_bento_icra24/blob/main/docs/rulebook.md#312-given-robotic-components), are we restricted to using only the provided robotic components? Specifically, are we prohibited from using additional equipment such as lidar or extra cameras for the technical challenge?

cxdcxd, 2024-05-10:
Yes, you can use any kind of hardware, sensor to use during technical challenge.

But for the main part you cannot use additional sensors, actuators. You can just use any custom computing unit. You have to consider the power source as well.

Closed 2024-05-27.
