olive-robotics/bots_bento_icra24/3d_models/Camera/v3/camera-asm_v1.pdf

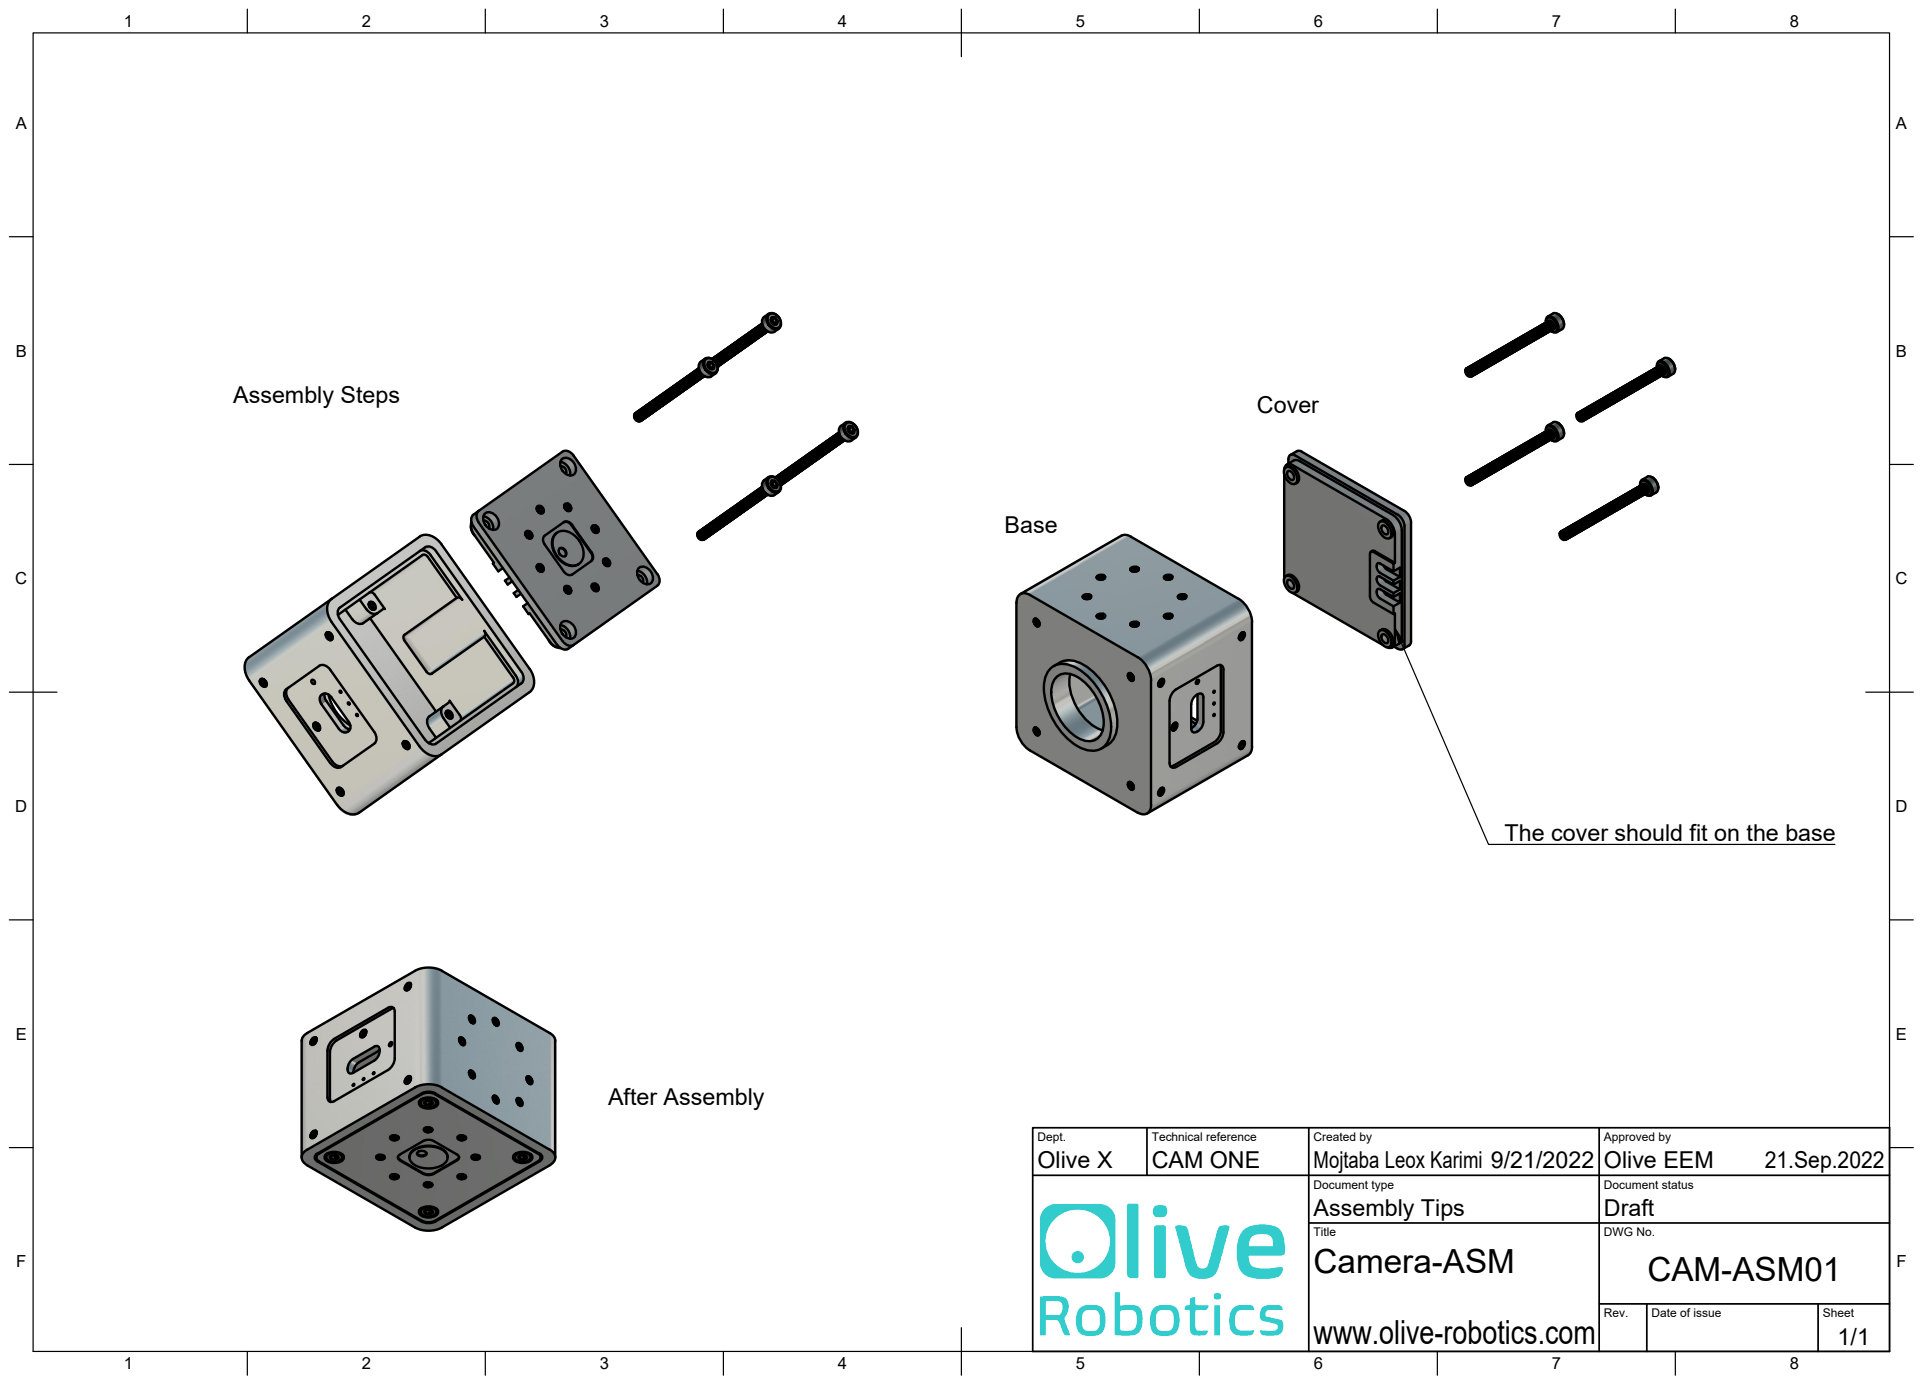
[picture p127: page 1]
Title; DWG No.; Rev.; Date of issue; Sheet; Assembly Steps; After Assembly

The cover should fit on the base

Dept. Olive X | Technical reference CAM ONE | Created by Mojtaba Leox Karimi 9/21/2022 | Approved by Olive EEM 21.Sep.2022

Document type Assembly Tips | Document status Draft

www.olive-robotics.com
