olive-robotics/bots_bento_icra24/3d_models/Camera/v3/camera-base_v1.pdf

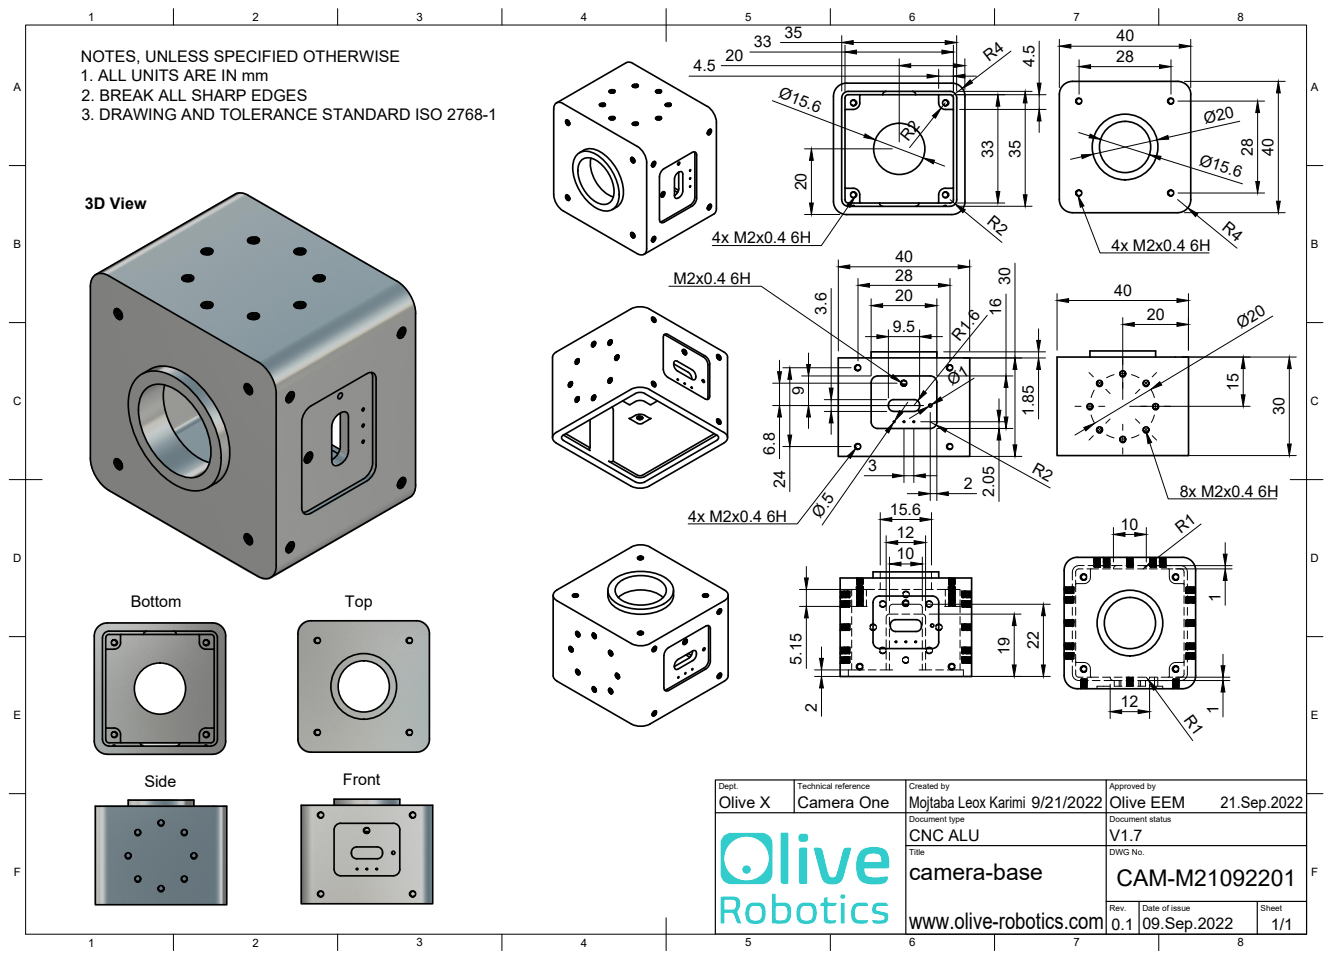
[picture p128: page 1]
Dept.; Technical reference; Created by; Approved by; Document type; Document status; Title; DWG No.; Rev.; Date of issue; Sheet; CNC ALU; Olive X; Camera One; Mojtaba Leox Karimi; Olive EEM; 3D View

NOTES, UNLESS SPECIFIED OTHERWISE
1. ALL UNITS ARE IN mm
2. BREAK ALL SHARP EDGES
3. DRAWING AND TOLERANCE STANDARD ISO 2768-1

www.olive-robotics.com 0.1 09.Sep.2022
