olive-robotics/bots_bento_icra24/3d_models/Imu/v3/imu_asm_v3.pdf

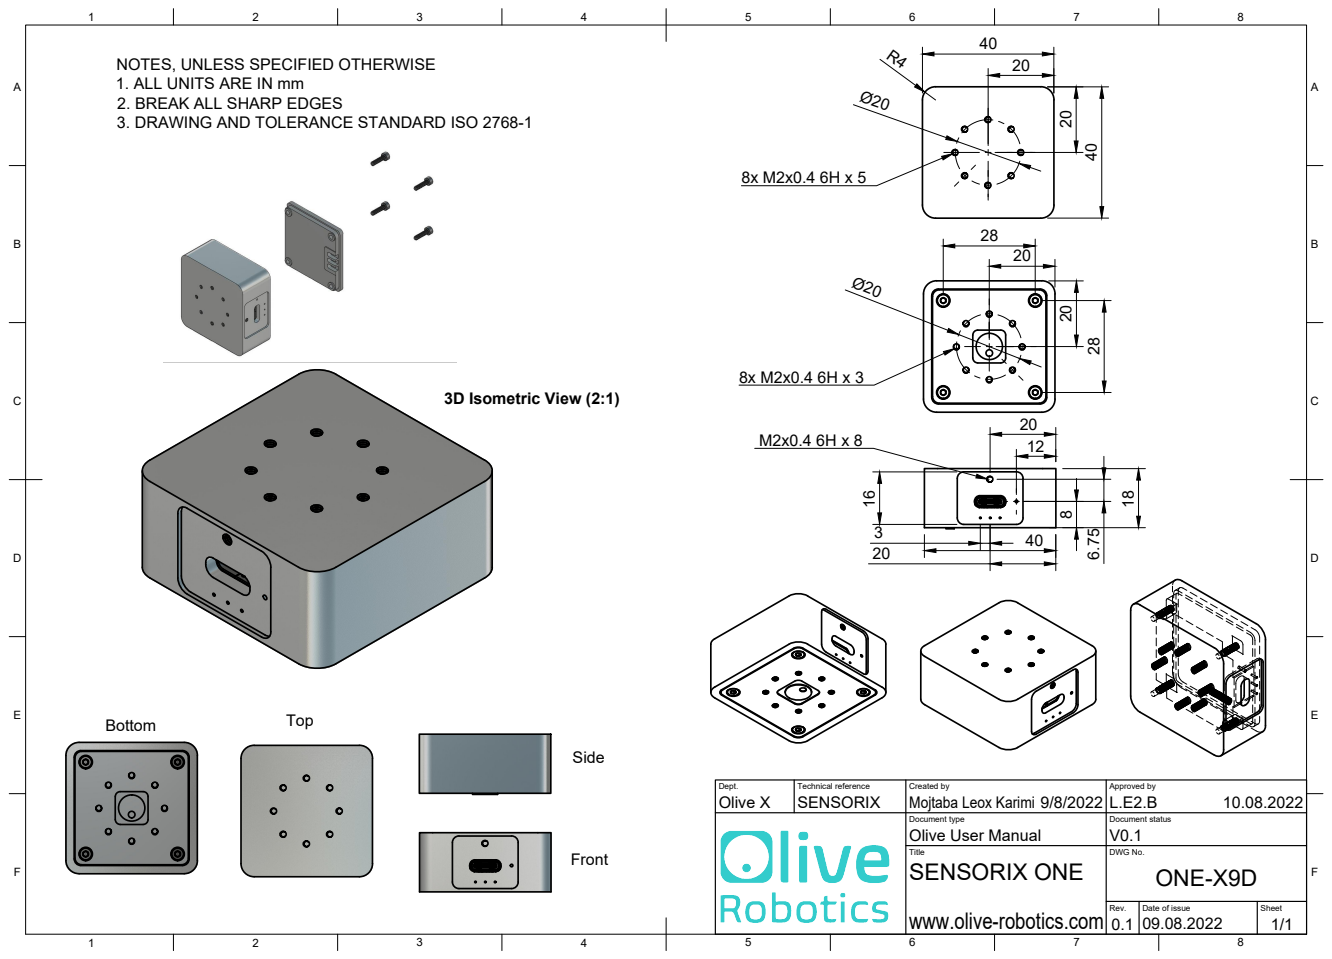
[picture p129: page 1]
Title; DWG No.; Rev.; Date of issue; Sheet; SENSORIX ONE; ONE-X9D; 3D Isometric View (2:1)

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

Dept. Olive X | Technical reference SENSORIX | Created by Mojtaba Leox Karimi 9/8/2022 | Approved by L.E2.B 10.08.2022

Document type Olive User Manual | Document status V0.1
