olive-robotics/bots_bento_icra24/3d_models/Imu/v3/imu_base_v3.pdf

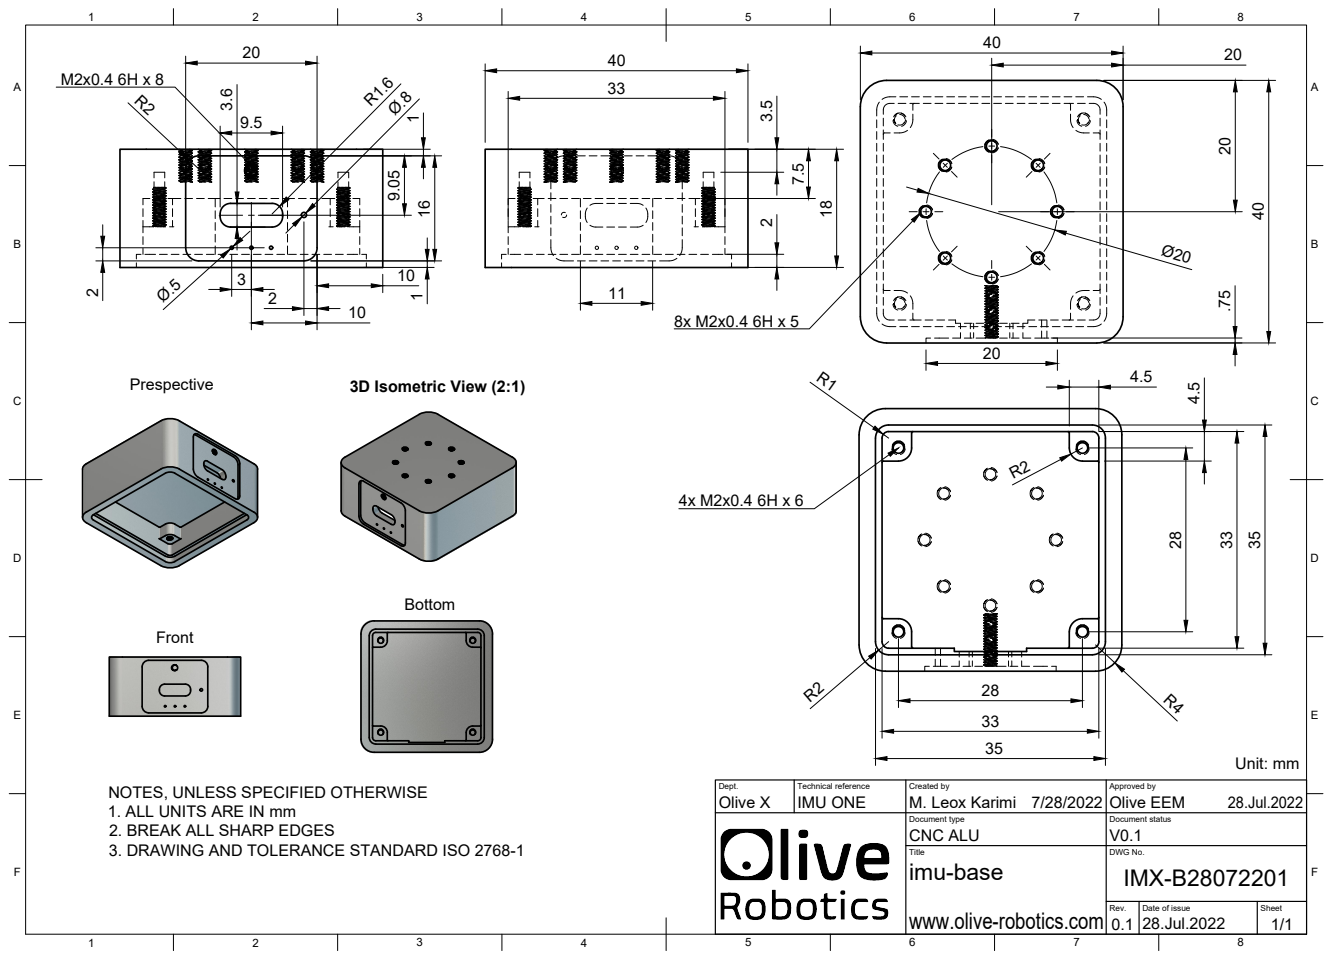
[picture p130: page 1]
Title; DWG No.; Rev.; Date of issue; Sheet; Unit: mm; 3D Isometric View (2:1)

Dept. Olive X | Technical reference IMU ONE | Created by M. Leox Karimi 7/28/2022 | Approved by Olive EEM 28.Jul.2022

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

Document type CNC ALU | Document status V0.1
