olive-robotics/bots_bento_icra24/3d_models/Camera/v3/cover_v1.pdf

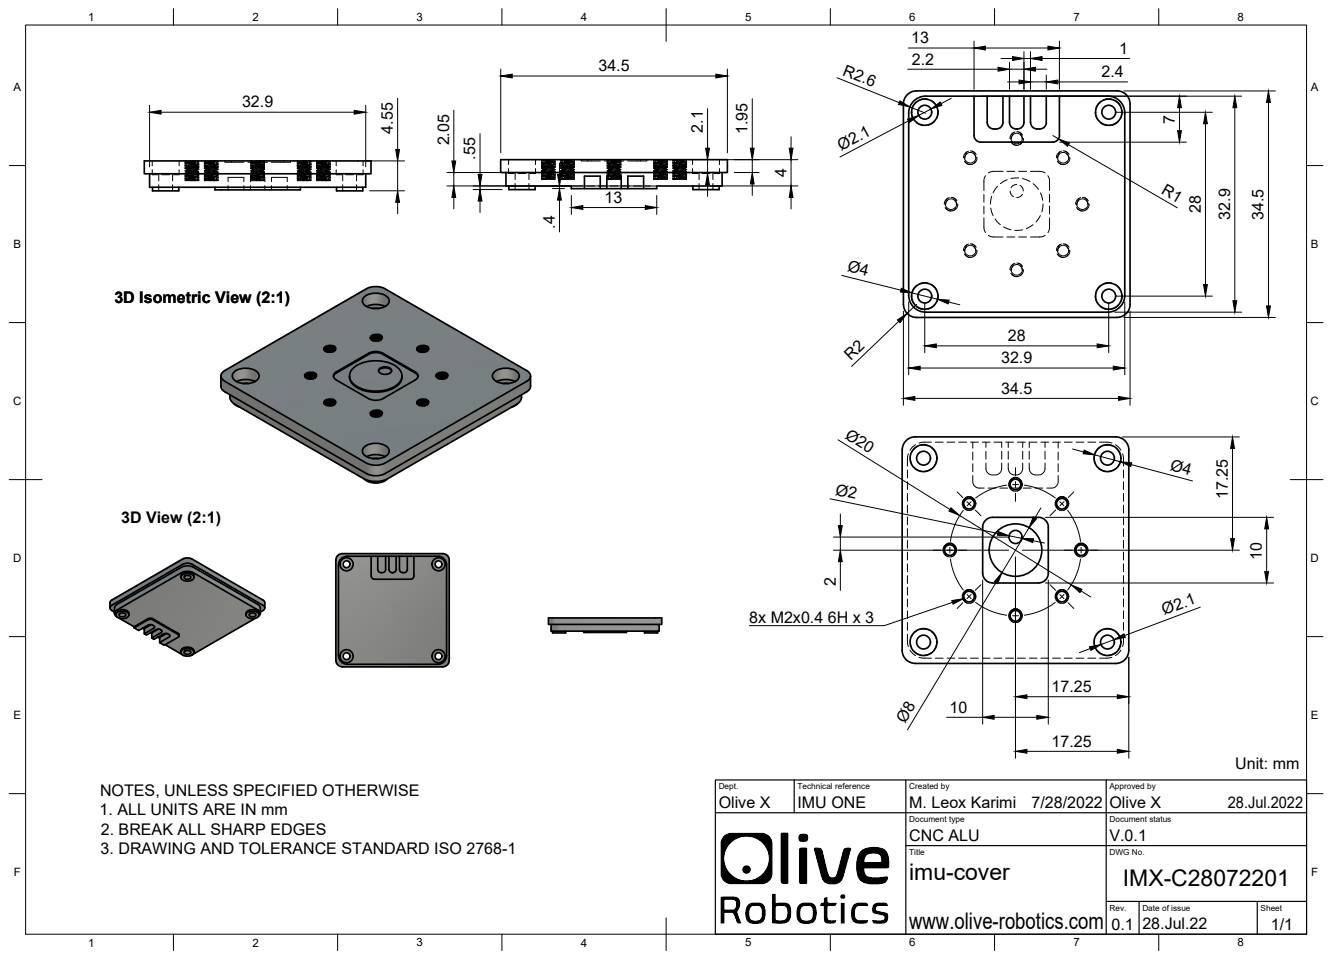
[picture p131: page 1]
Title; DWG No.; Rev.; Date of issue; Sheet; Olive X; IMU ONE; M. Leox Karimi; Unit: mm; 3D Isometric View (2:1); 3D View (2:1)

Dept. | Technical reference | Created by 7/28/2022 | Approved by 28.Jul.2022

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

Document type CNC ALU | Document status V.0.1
