olive-robotics/bots_bento_icra24/(commit log)

2024-02-18 3D models added.
    [Bolt-Hex-F-plastic v4.stl, Bolt-Hex-M-plastic v4.stl, IMU-ASM v7.3dm, camera-base_v1.step, camera_asm_full v14.3dm, cove_v3.step, cover_v1.step, horn.step]
2024-02-18 3d models updated.
    [horn.step, servo_back_v2.step, servo_body_v2.step, servo_middle_v2.step]
2024-04-08 Camera parameter update.
