olive-robotics/bots_bento_icra24/docs/images/passive.JPG

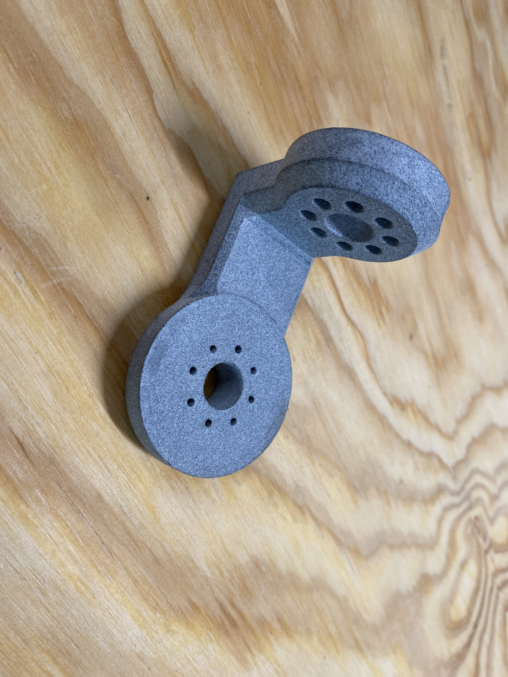
[picture p124: docs/images/passive.JPG]
docs/images/passive.JPG
